EdgeCoil/wiegand-bridge/hardware/fab/render-bottom.png

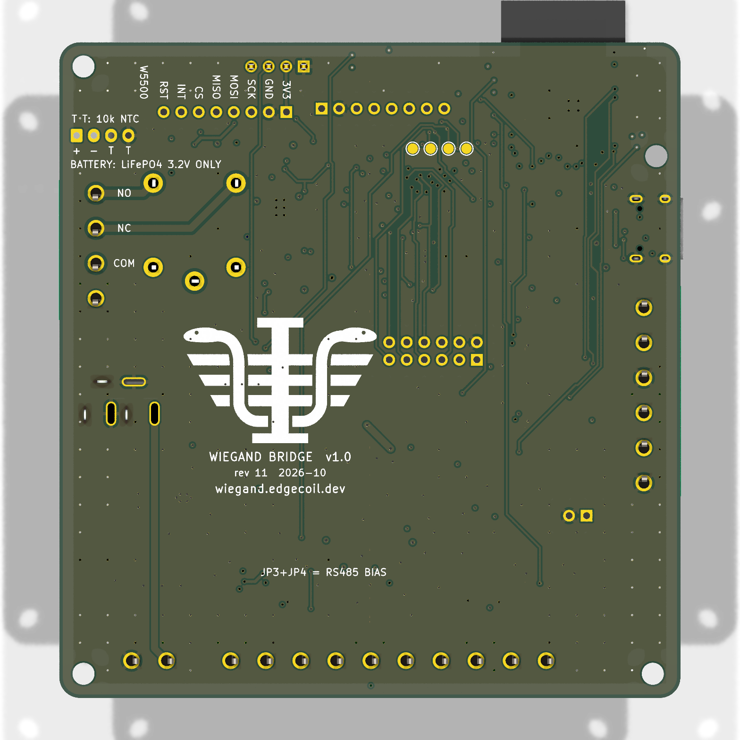
hardware/fab/render-bottom.png
