EdgeCoil/wiegand-bridge/hardware/fab/render-perspective.png

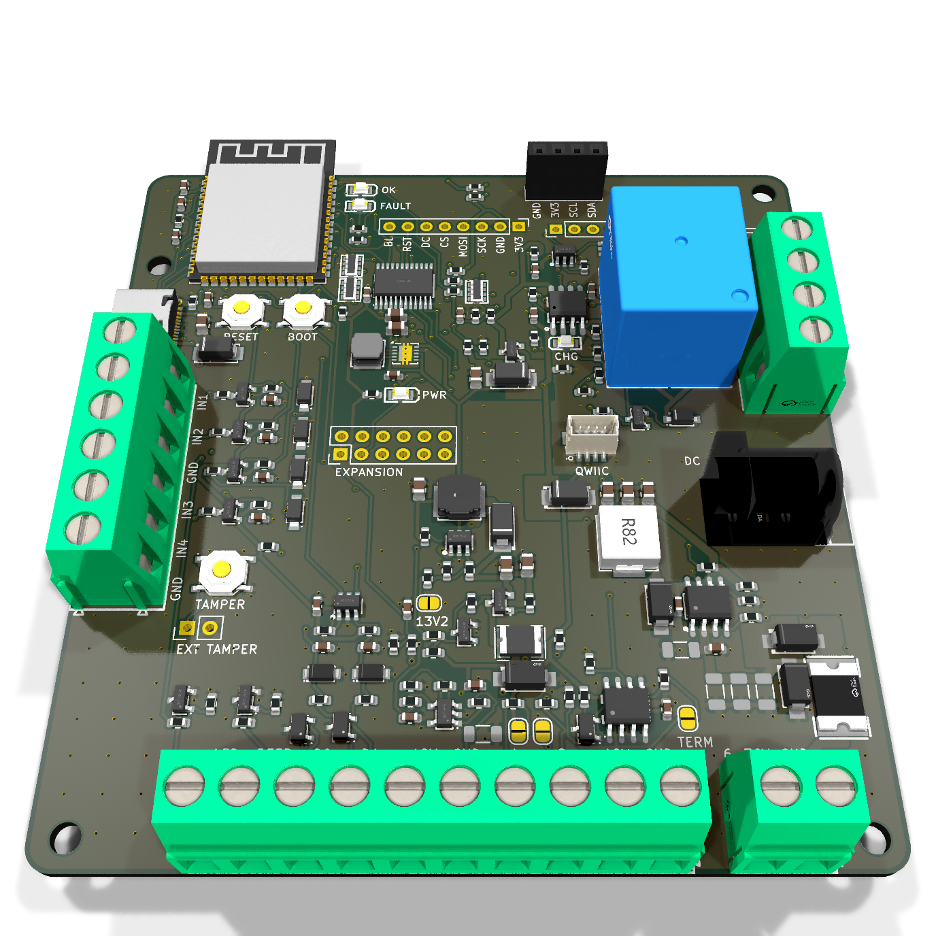
hardware/fab/render-perspective.png
