EdgeCoil/wiegand-bridge/hardware/lite/fab/render-bottom.png

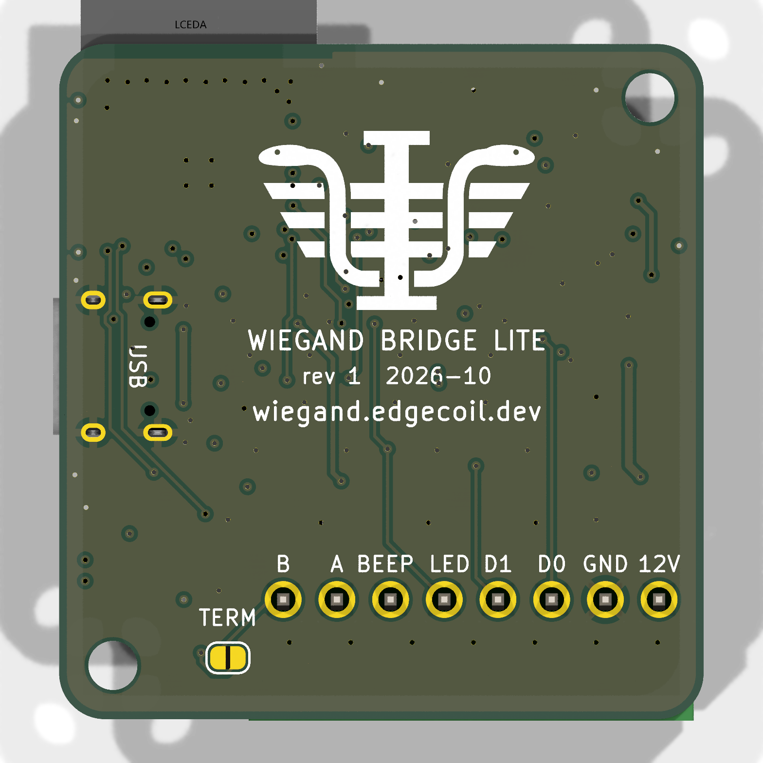
hardware/lite/fab/render-bottom.png
