EdgeCoil/wiegand-bridge/hardware/lite/fab/render-top.png

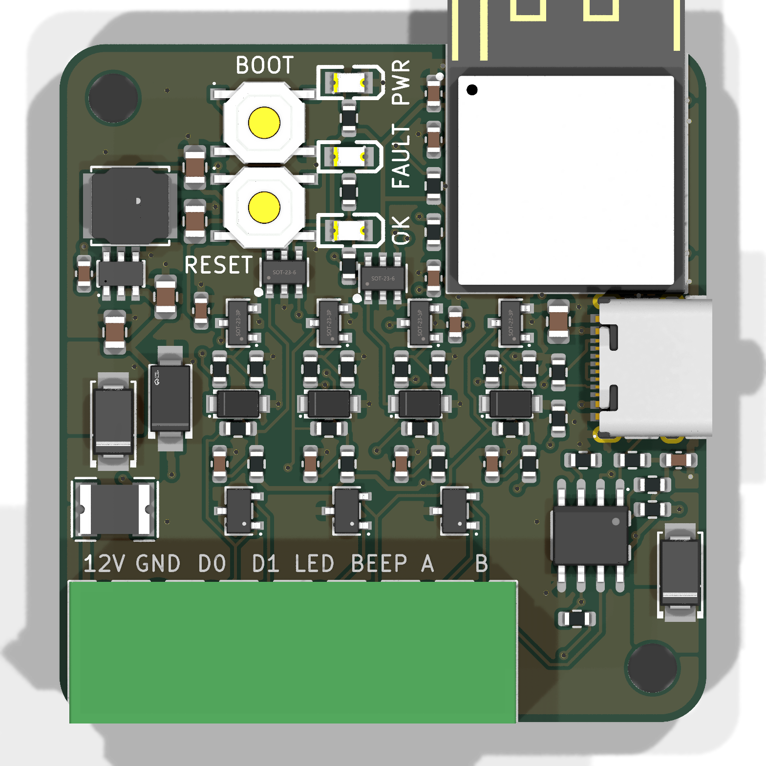
hardware/lite/fab/render-top.png
