EdgeCoil/wiegand-bridge/hardware/fab/wiegand-bridge-bom.csv

Comment | Designator | Footprint | LCSC Part #
22u | C11 | C_0603_1608Metric | C59461
1u | C13 | C_0603_1608Metric | C15849
100p | C14,C15 | C_0603_1608Metric | C14858
10n | C27,C28,C29,C30 | C_0603_1608Metric | C57112
10u | C2,C31,C32,C33 | C_1206_3216Metric | C13585
100n | C3,C12,C16,C22,C23,C24,C34,C36,C37,C38,C39,C40 | C_0603_1608Metric | C14663
22u | C4,C5,C7,C9,C10,C17,C18,C19,C35 | C_0805_2012Metric | C45783
10u | C6 | C_0805_2012Metric | C15850
10u | C8,C20,C21 | C_0603_1608Metric | C19702
SS56 | D1,D13 | SMA_L4.3-W2.6-LS5.0-RD | C18199169
1N4148W | D14 | SOD-123F_L2.7-W1.6-LS3.8-RD | C81598
SM712 | D15,D16,D19 | SOT-23-3_L3.0-W1.7-P0.95-LS2.9-BR | C32677
SMF36CA | D17,D18,D21,D22 | SOD-123FL_L2.7-W1.8-LS3.8-BI | C19077521
SMAJ36CA | D2 | SMA_L4.3-W2.6-LS5.0-RD | C19077551
SMAJ15A | D20 | SMA_L4.3-W2.6-LS5.0-RD | C19077535
SS34 | D3,D4,D10,D11 | SMA_L4.3-W2.6-LS5.2-RD | C8678
MMSZ5231B | D5,D6 | SOD-123_L2.8-W1.6-LS3.7-RD | C19077422
green | D7,D23 | LED0805-R-RD | C2297
red | D8,D12 | LED0805-RD | C84256
0.5A | F1 | F1812 | C516067
2A 60V | F2 | F2920 | C49326266
USB-C | J1 | USB-C-SMD_TYPE-C-16PIN-2MD-073 | C2765186
KF128-5.08-2P screw terminal | J2,J3,J9,J10,J11,J12,J13,J20,J21 | CONN-TH_P5.08_KF128-5.08-2P | C474952
LiFePO4 + NTC | J4 | JST_XH_B4B-XH-A_1x04_P2.50mm_Vertical | C144395
OLED SOCKET | J5 | HDR-TH_4P-P2.54-V-F | C2718488
15uH | L1 | IND-SMD_L7.0-W6.6_FXL0630 | C177243
2.2uH | L2 | IND-SMD_L4.0-W4.0 | C279948
4.7uH | L3 | IND-SMD_L5.0-W5.0 | C305174
2N7002 | Q1,Q2,Q4,Q7,Q8,Q9,Q10 | SOT-23-3_L2.9-W1.3-P1.90-LS2.4-BR | C8545
AO3401A | Q5,Q11 | SOT-23_L2.9-W1.3-P1.90-LS2.4-BR | C15127
AO3400A | Q12 | SOT-23-3_L2.9-W1.3-P1.90-LS2.4-BR | C20917
FS8205A | Q6 | SOT-23-6_L2.9-W1.6-P0.95-LS2.8-BR | C2830320
5.1k | R1,R2,R77 | R_0603_1608Metric | C23186
10k | R4,R5,R11,R12,R15,R18,R20,R35,R44,R45,R46,R47,R50,R60,R65,R74,R75,R76 | R_0603_1608Metric | C25804
15k | R16,R32 | R_0603_1608Metric | C22809
200k | R19,R30,R80 | R_0603_1608Metric | C25811
1k | R3,R8,R9,R10,R24,R26,R40,R41,R42,R43,R63,R70,R71,R81 | R_0603_1608Metric | C21190
4.7k | R36,R37 | R_0603_1608Metric | C23162
39k | R55 | R_0603_1608Metric | C23153
47k | R56 | R_0603_1608Metric | C25819
8.2k | R57 | R_0603_1608Metric | C25981
100k | R13,R14,R21,R27,R28,R29,R31,R51,R52,R58,R61,R62,R64,R79 | R_0603_1608Metric | C25803
0.2R | R59 | R_1206_3216Metric | C25335
100 | R6,R7,R17,R25 | R_0603_1608Metric | C22775
20k | R66,R67,R69 | R_0603_1608Metric | C4184
120 | R68 | R_0603_1608Metric | C22787
390 | R72,R73 | R_0603_1608Metric | C23151
68k | R78 | R_0603_1608Metric | C23231
4x10k | RN1,RN2,RN3 | RES-ARRAY-SMD_0603-8P-L3.2-W1.6-BL | C29718
10k NTC B3950 | RT1 | R_0603_1608Metric | C2892547
TS-1187A tact switch | SW1,SW2,SW3 | SW-SMD_4P-L5.1-W5.1-P3.70-LS6.5-TL_H1.5 | C318884
ESP32-S3-WROOM-1-N8R2 | U1 | WIRELM-SMD_ESP32-S3-WROOM-1 | C2913204
LMV321 | U10 | SOT-23-5_L3.0-W1.7-P0.95-LS2.8-BR | C7972
LMR16020 | U2 | SOIC-8_L4.9-W3.9-P1.27-LS6.0-BL-EP | C190006
TPS63001 | U3 | Texas_DRC0010J | C28060
SN74LVC2G17 | U4 | SOT-23-6_L2.9-W1.6-P0.95-LS2.8-BL | C10429
CN3058E | U5 | SOIC-8_L4.9-W3.9-P1.27-LS6.0-BL-EP3.3 | C112011
MT3608 | U6 | SOT-23-6_L2.9-W1.6-P0.95-LS2.8-BL | C84817
DW01A | U7 | SOT-23-6_L2.9-W1.6-P0.95-LS2.8-BL | C351410
TCA9535 | U8 | TSSOP-24_L7.8-W4.4-P0.65-LS6.4-BL | C130204
SP3485 | U9 | SOIC-8_L5.0-W4.0-P1.27-LS6.0-BL | C8963
