EdgeCoil/wiegand-bridge/hardware/fab/wiegand-bridge-schematic.pdf

# Wiegand reader bridge — revision 11 schematic

Generated from netlist.py (netlistsvg). Supply nets are flags; nets shared between blocks are named ports. IC pins are shown as

1. Block 1: 6-36 V input 2. Block 2: buck to 5 V (LMR16020, 60 V; datasheet SNVSAH8A sec. 8.2) 3. Block 3: USB-C, +5V, VSYS 4. Block 4: 3.3 V buck-boost 5. Block 5: MCU 6. Block 6: Wiegand inputs 7. Block 7: LED and BEEP 8. Block 8: reader supply 9. Block 9: battery 10. Block 10: screens 11. Block 11: inputs 12. Block 12 (rev 10): I/O expander, TCA9535 at 0x20 13. Block 13 (rev 10): relay -- driver fitted, relay and terminals NOT fitted 14. Block 14 (rev 10): RS-485 / OSDP on UART0 15. Block 15 (rev 10): surge/ESD on every field wire (SM712: +12 / -7 V standoff) 16. Block 16 (rev 10): reader current sense 17. Block 17 (rev 10): W5500 module header and Qwiic, not fitted

+VIN_RAW

GND

J2 6-36V IN
1 2

GND

GND

+VIN_RAW

J14 DC IN
2

3

4

+VIN_RAW
+VIN_F

F2 2A 60V
1 2+VIN

+VIN_F

D1

+VIN
GND

D2

+VIN

GND

C31

10u

+VIN

GND

C32

10u

+VIN

GND

C33

10u

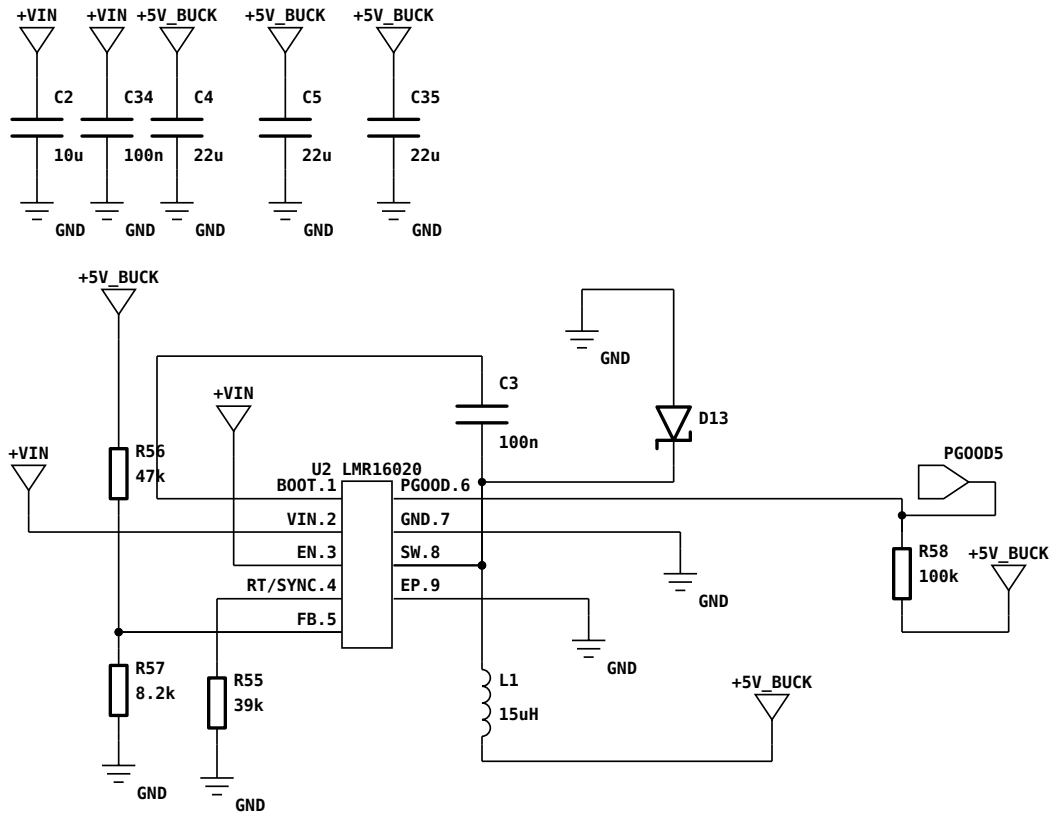
[picture p8: page 3]

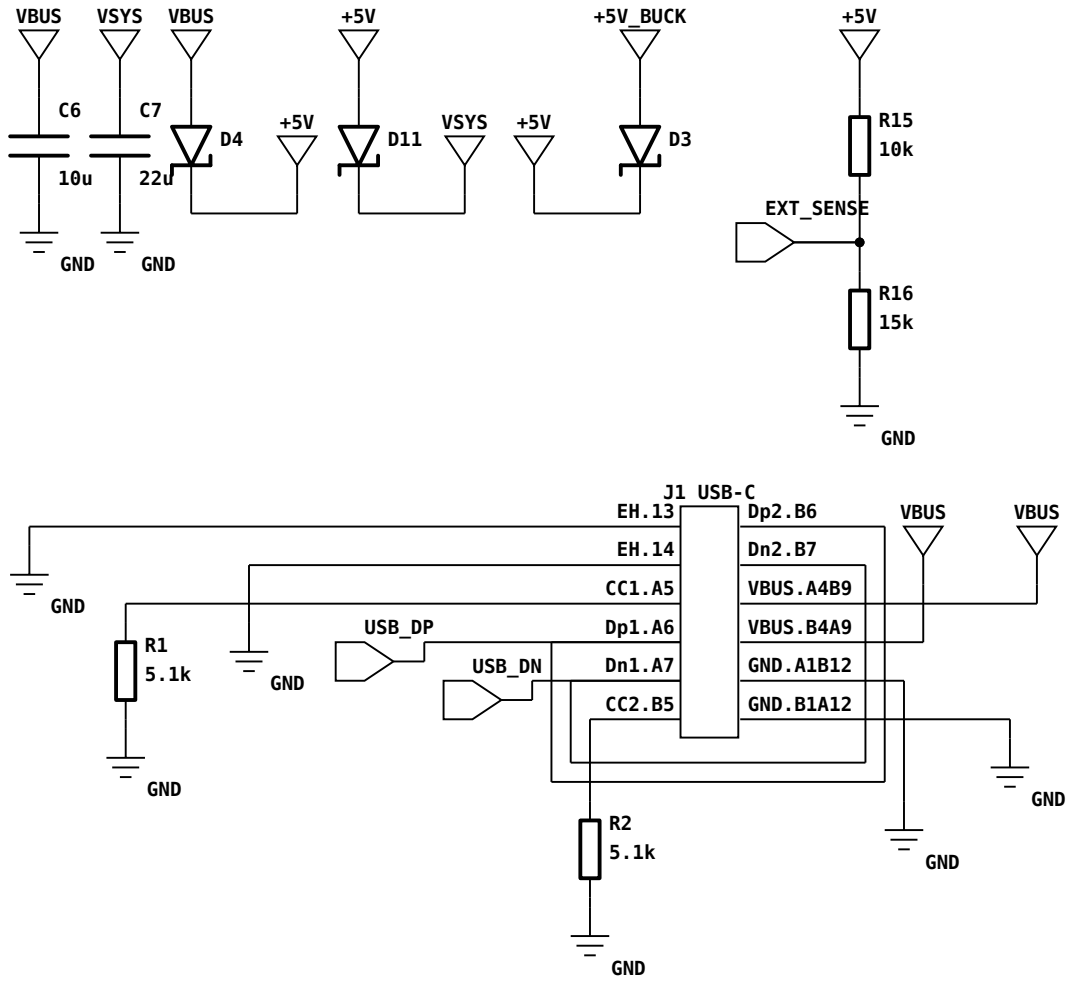
[picture p9: page 4]

VSYS

GND

C8

10u

+3V3

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
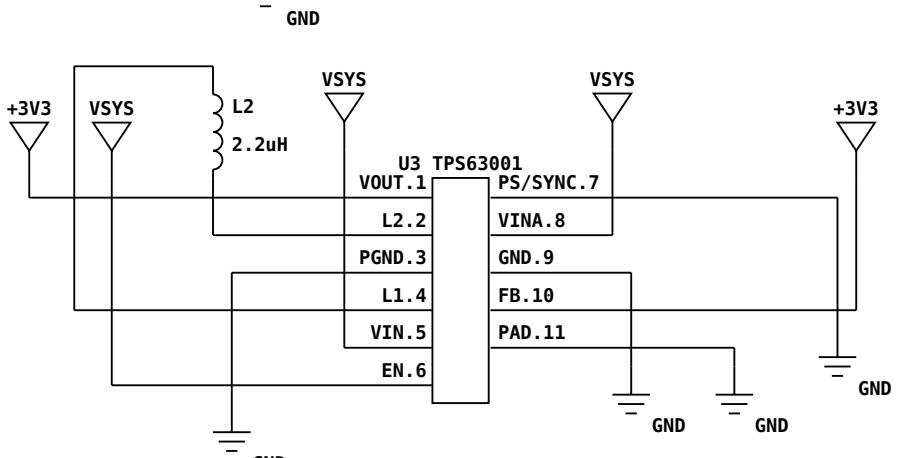
[picture p10: figure]
VSYS; GND; U3 TPS63001 VOUT.1; PGND.3; VIN.5; PS/SYNC.7; VINA.8; GND.9; PAD.11
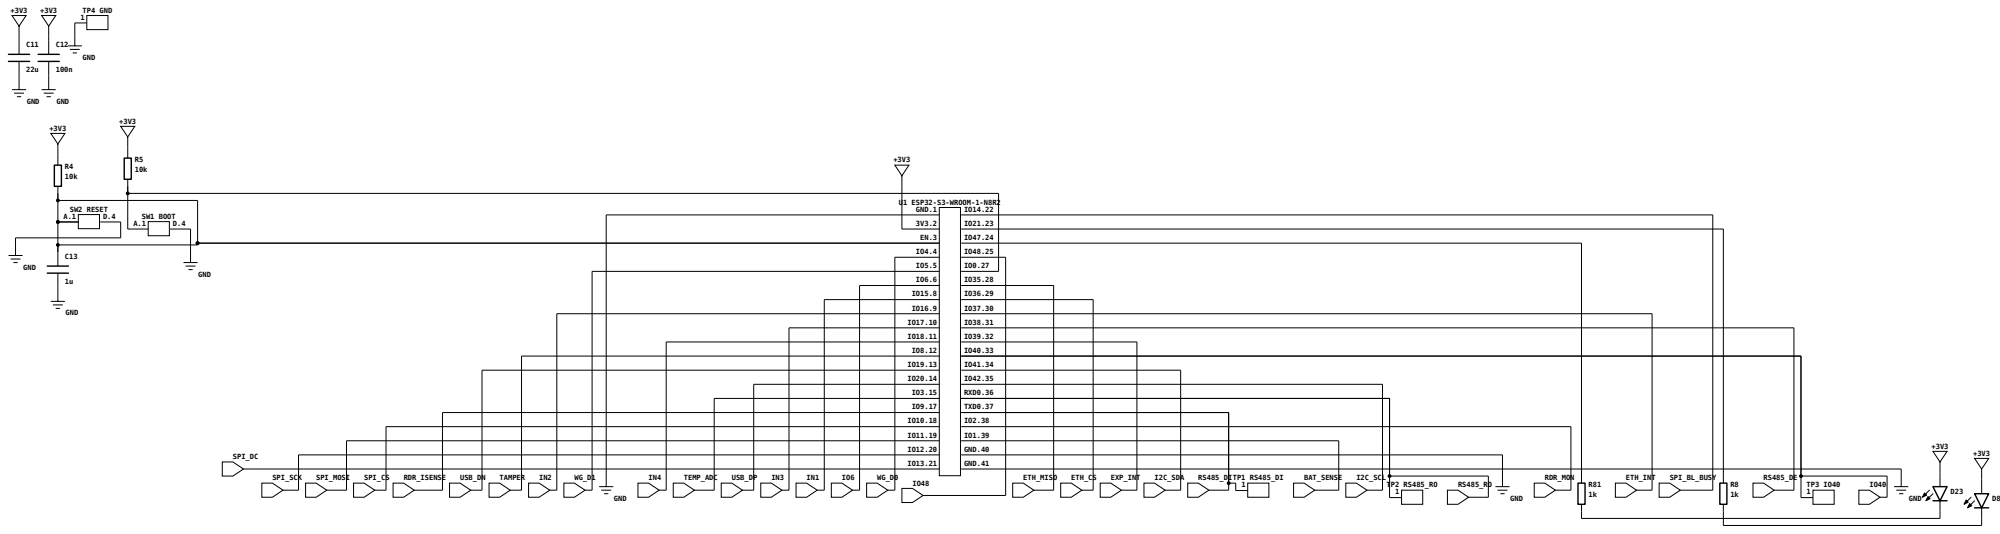
[picture p11: page 6]

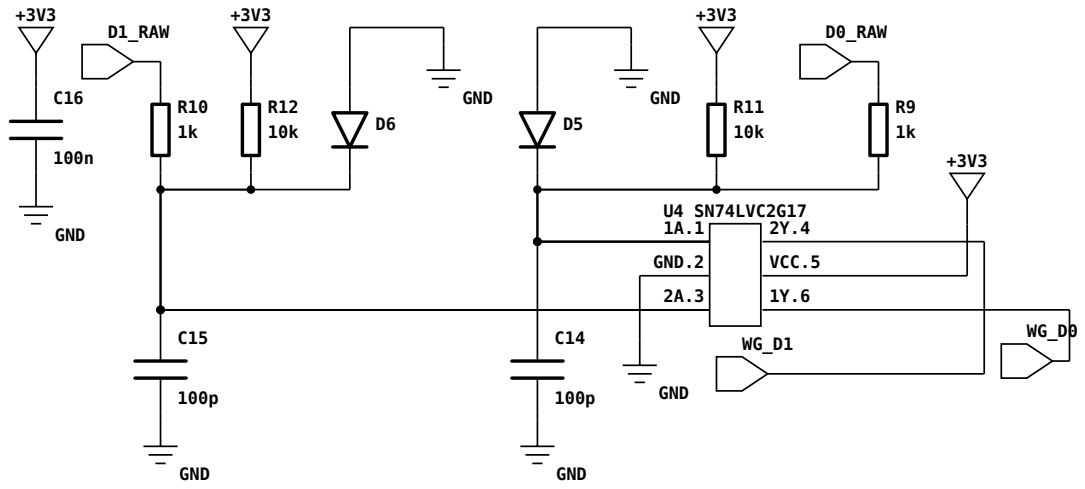
[picture p12: page 7]

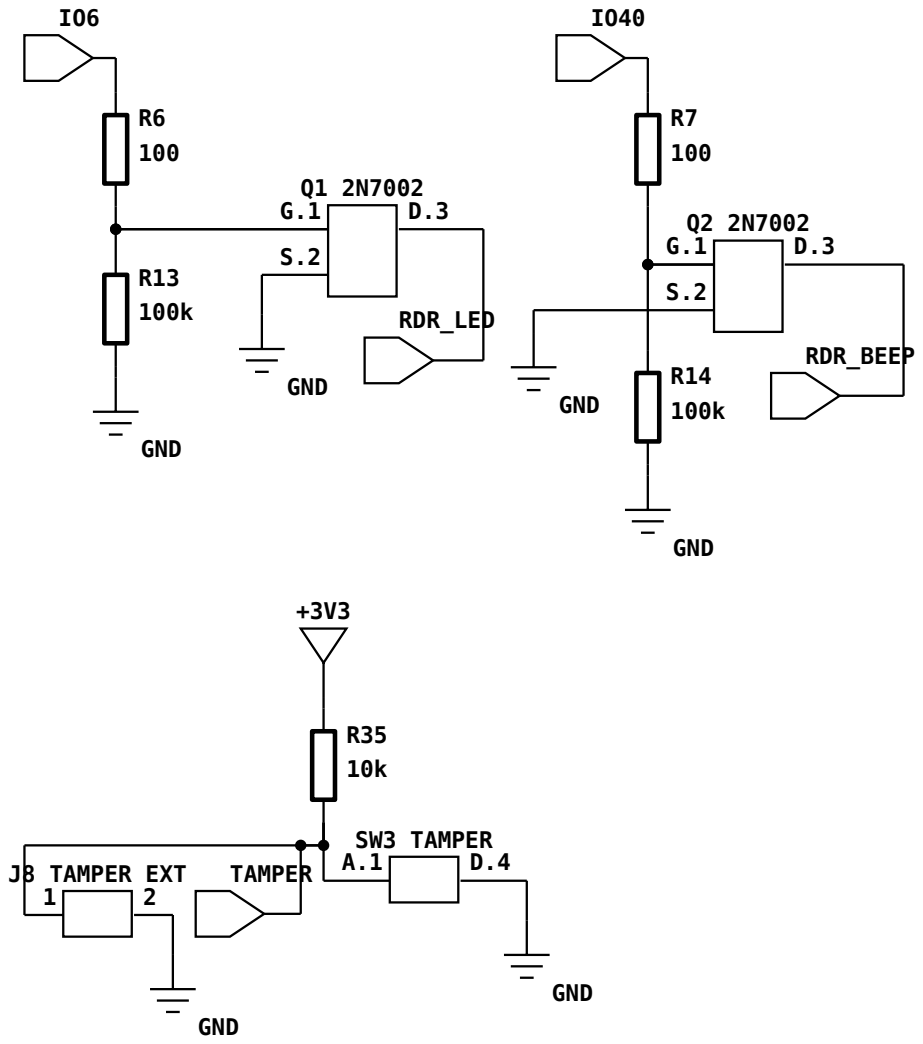
[picture p13: page 8]

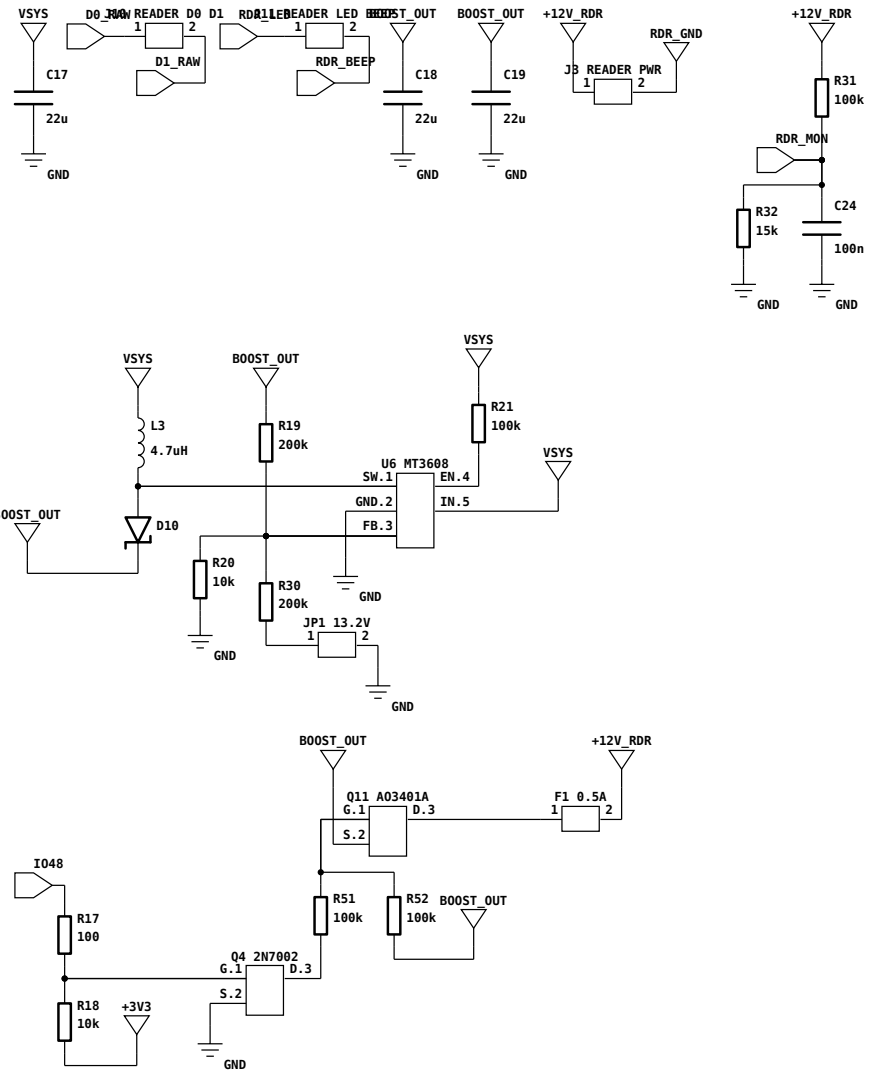
[picture p14: page 9]

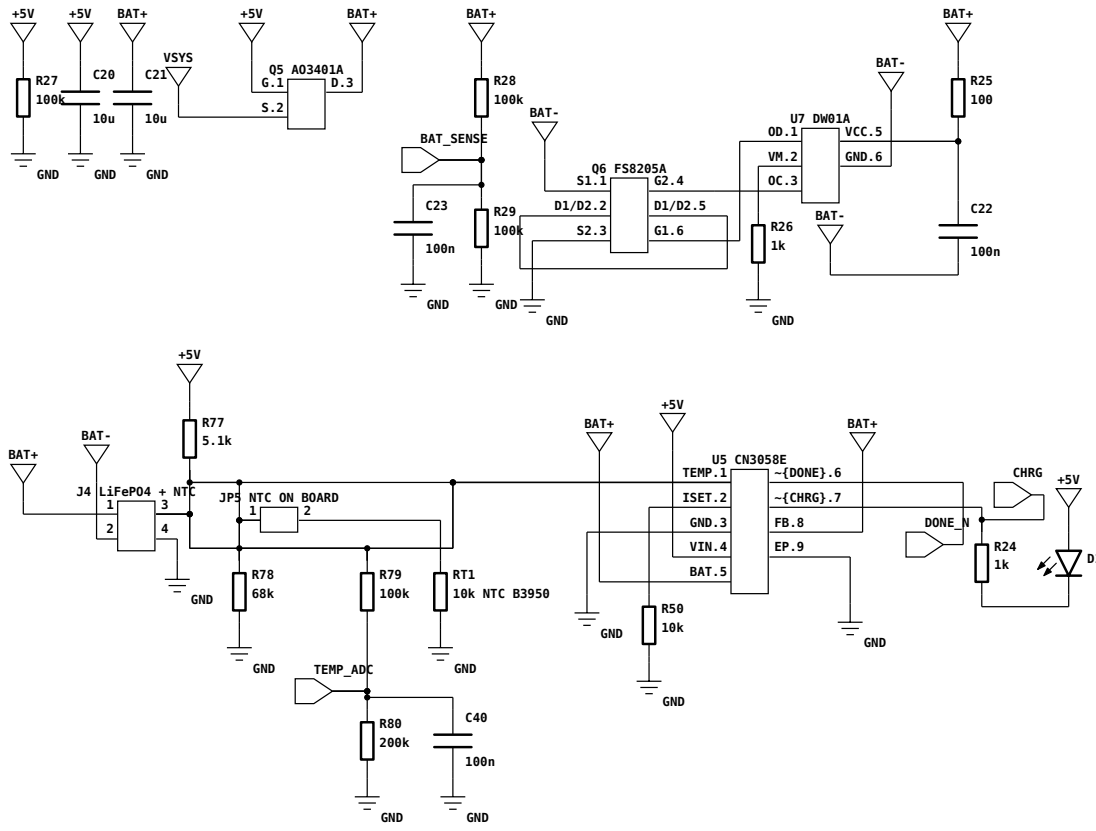
[picture p15: page 10]

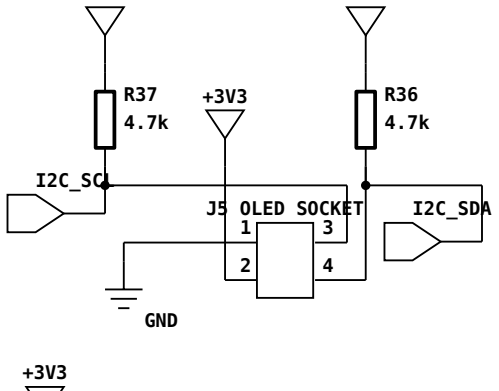
[picture p16: figure]
GND; J5 OLED SOCKET 1; I2C_SCL; I2C_SDA
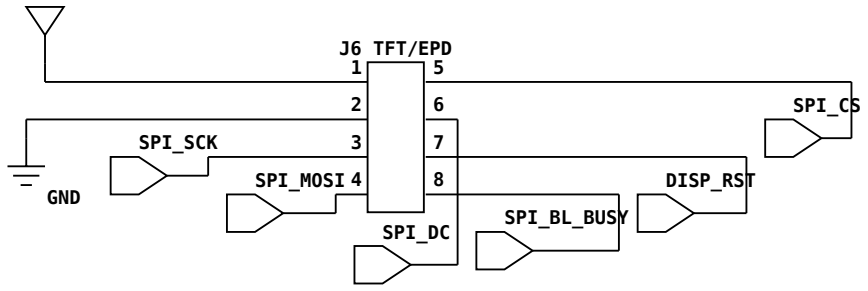
[picture p17: figure]
GND; J6 TFT/EPD 1; SPI_SCK; SPI_MOSI; SPI_CS; SPI_DC; DISP_RST; SPI_BL_BUSY
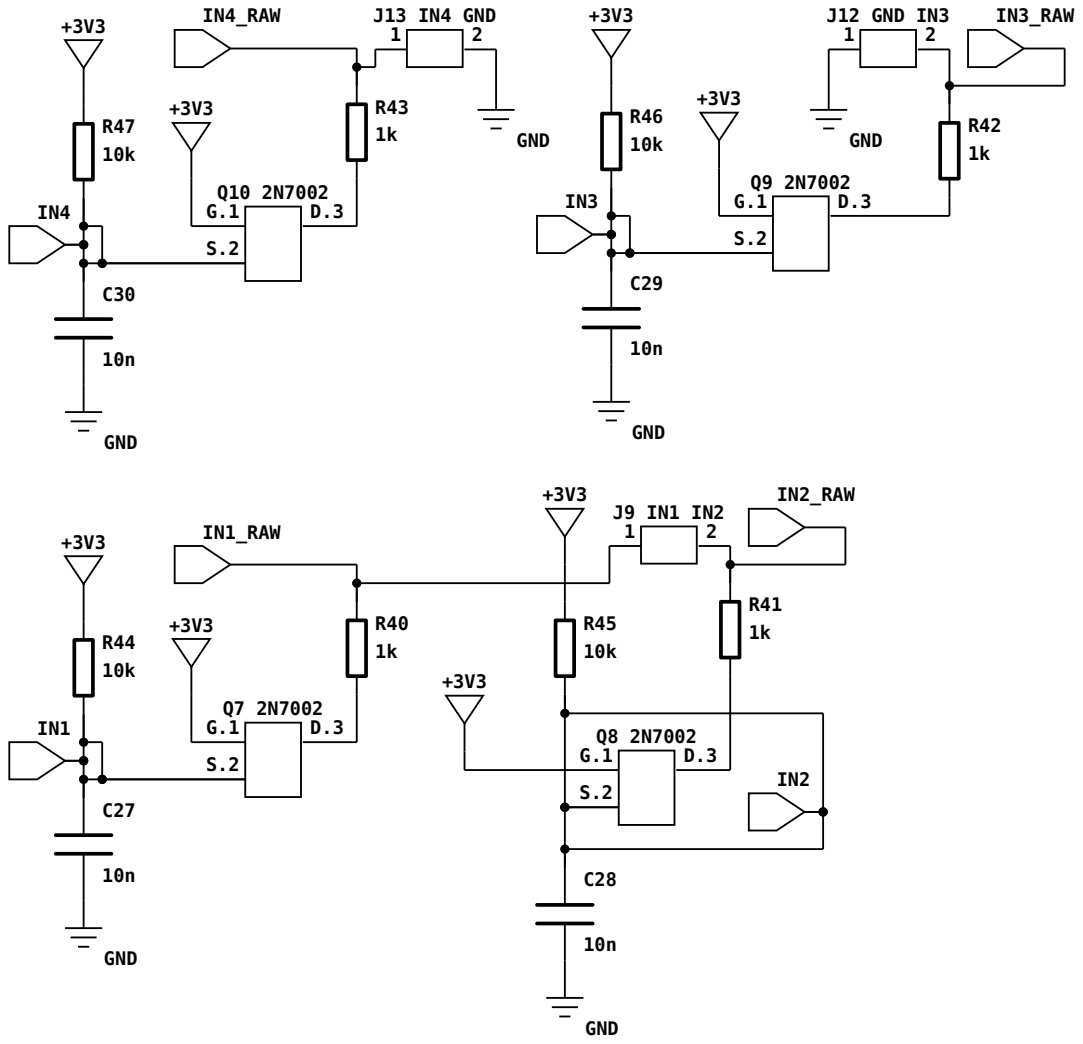
[picture p18: page 12]

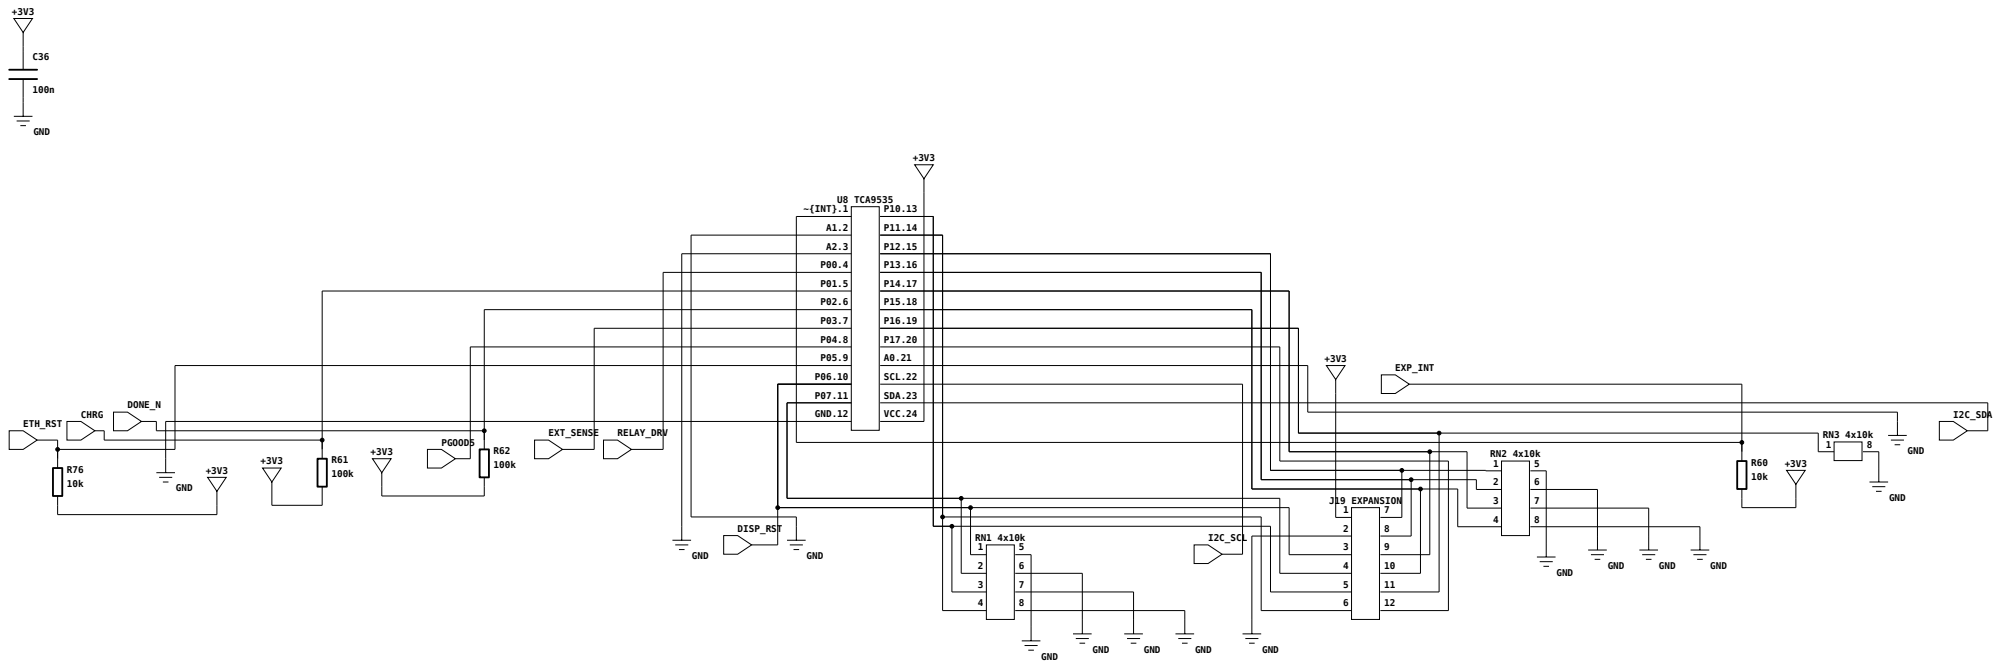
[picture p19: page 13]

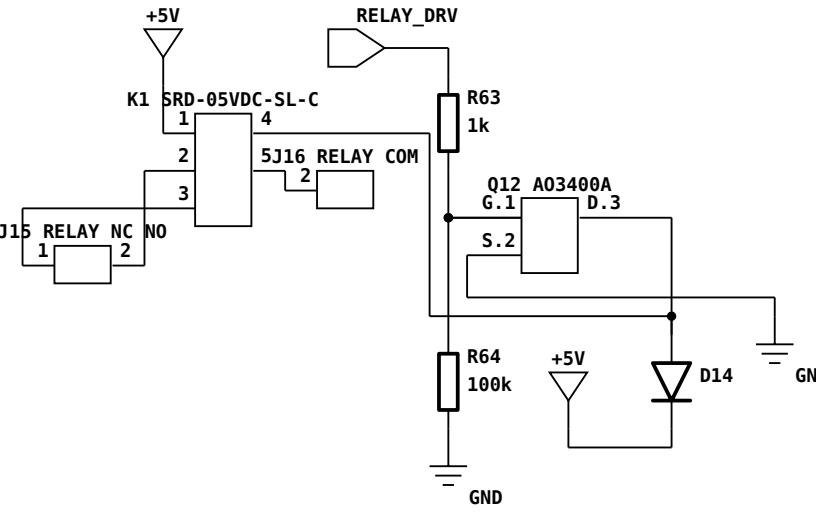
[picture p20: figure]
GND; SRD-05VDC-SL-C; J15 RELAY NC; J16 RELAY COM 2; RELAY_DRV
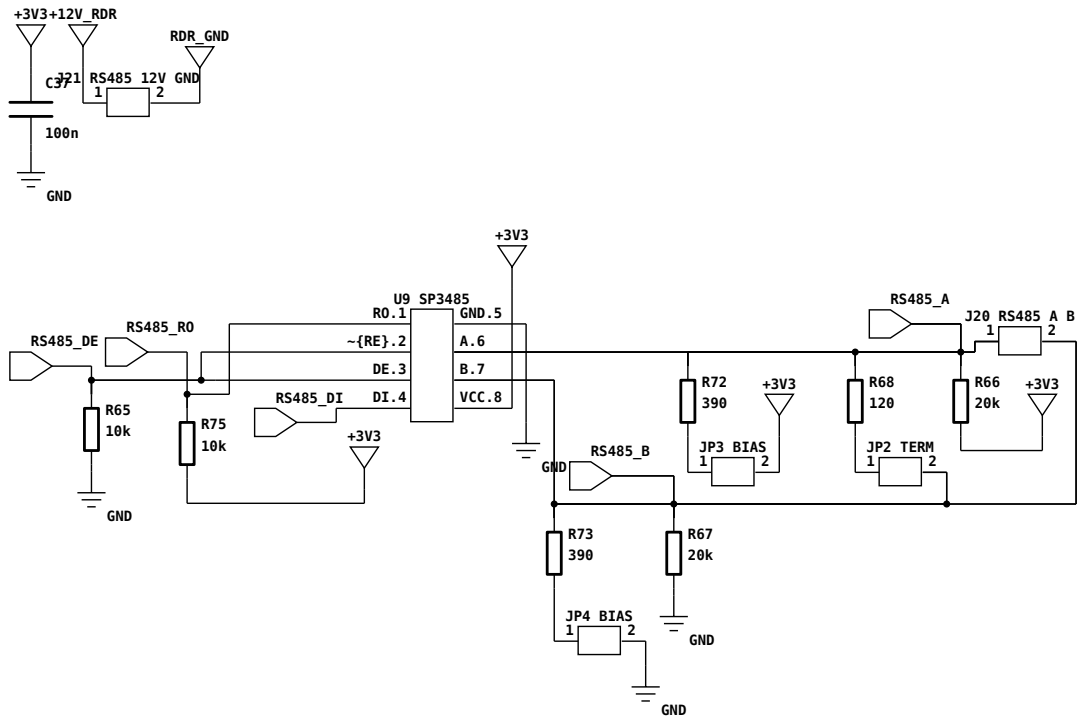
[picture p21: page 15]

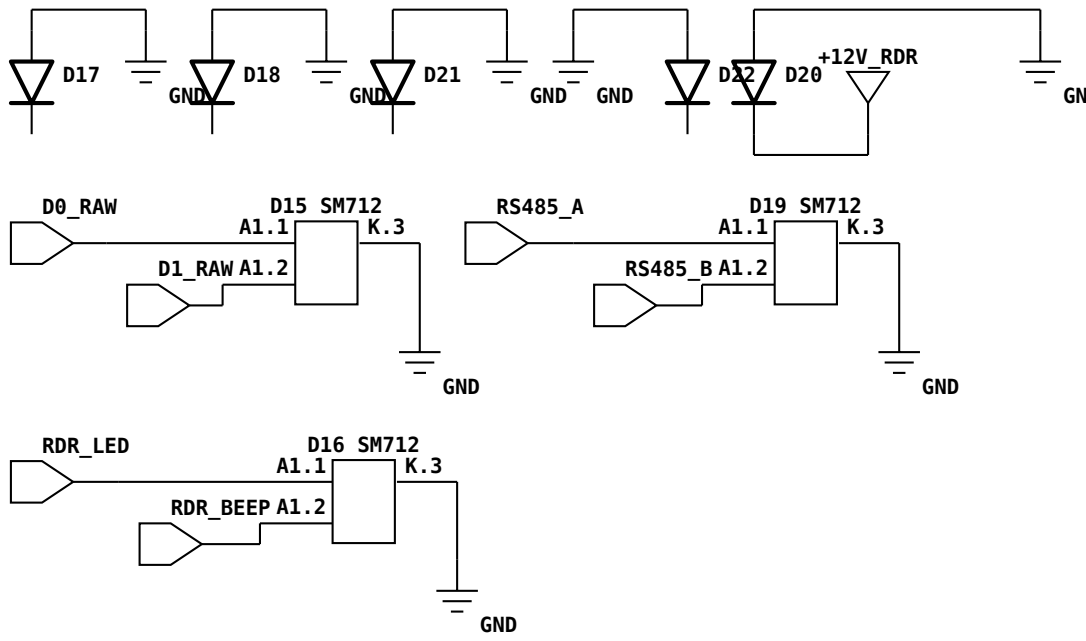
[picture p22: page 16]

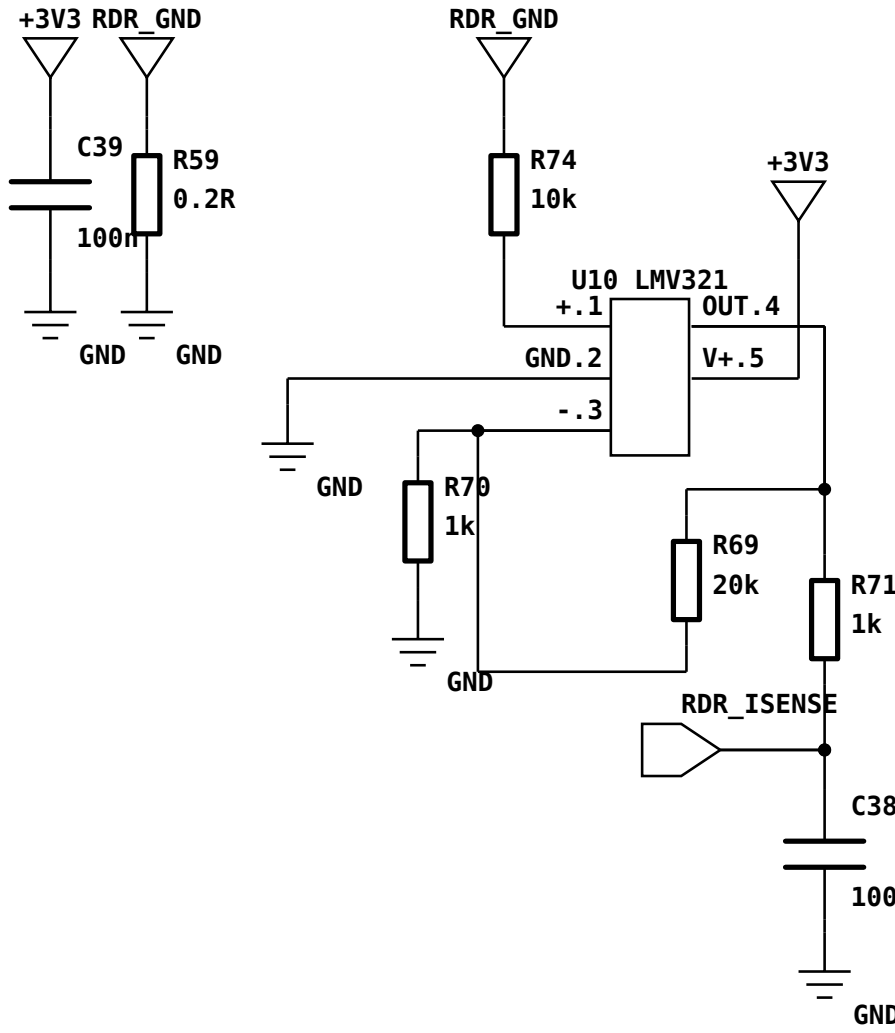
[picture p23: page 17]

J18 QWIIC
1

2

3

4
I2C_SDA

I2C_SCL

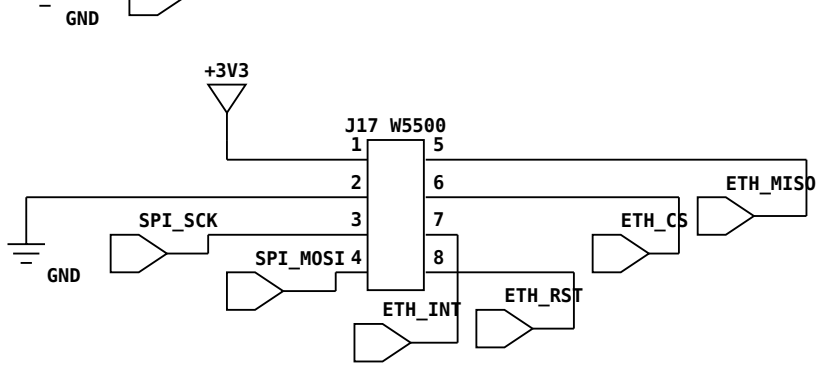
[picture p24: figure]
GND; SPI_SCK; SPI_MOSI; ETH_MISO; ETH_CS; ETH_INT; ETH_RST
