EdgeCoil/wiegand-bridge/hardware/lite/fab/wiegand-bridge-lite-1to1.pdf

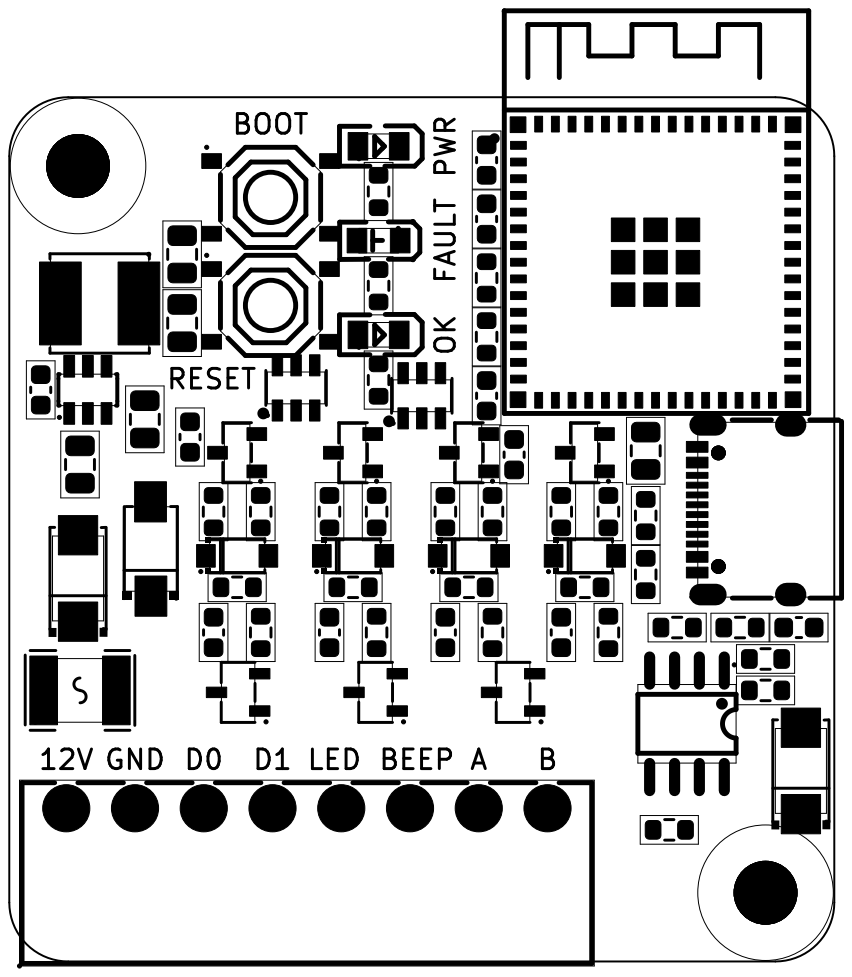
[picture p25: page 1]

Id: 1/1 Title: File: wiegand-bridge-lite.kicad_pcb Sheet:
