EdgeCoil/wiegand-bridge/hardware/lite/fab/wiegand-bridge-lite-schematic.pdf

# Wiegand bridge LITE — revision 1 schematic

Generated from netlist.py (netlistsvg). Supply nets are flags; nets shared between blocks are named ports. IC pins are shown as

1. Block 1: terminal block and 8-16 V input 2. Block 2: buck to 3.3 V (AP63203, datasheet figure 21) 3. Block 3: USB-C (programming, and bench power through D3) 4. Block 4: MCU, buttons, status LEDs 5. Block 5: reader lines D0, D1, LED, BEEP -- bidirectional cells 6. Block 6: RS-485 / OSDP on UART0 (rev 10 block 14, less the strong-bias jumpers) 7. Block 7: surge/ESD on every field wire (SM712: +12 / -7 V standoff)

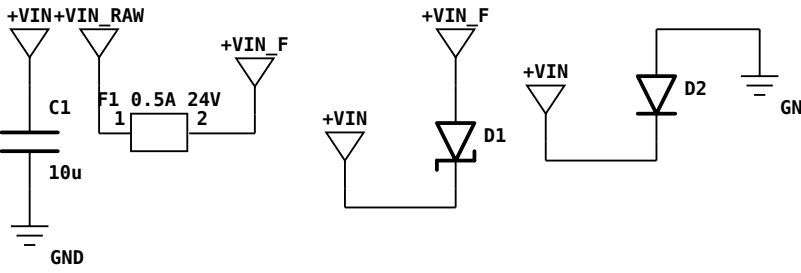
[picture p26: figure]
+VIN_RAW; +VIN_F; +VIN; GND
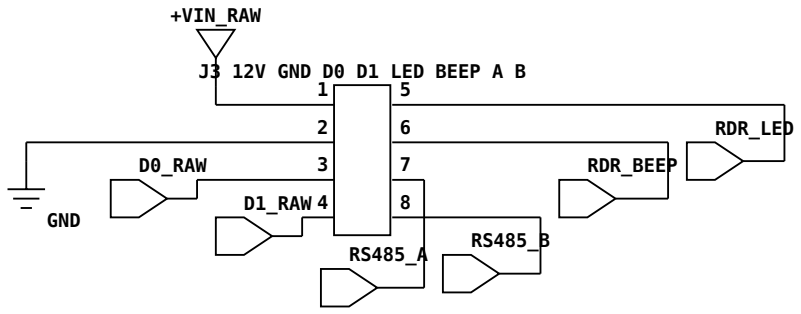
[picture p27: figure]
+VIN_RAW; GND; J3 12V GND D0 D1 LED BEEP A B 1; D0_RAW; D1_RAW; RDR_LED; RDR_BEEP
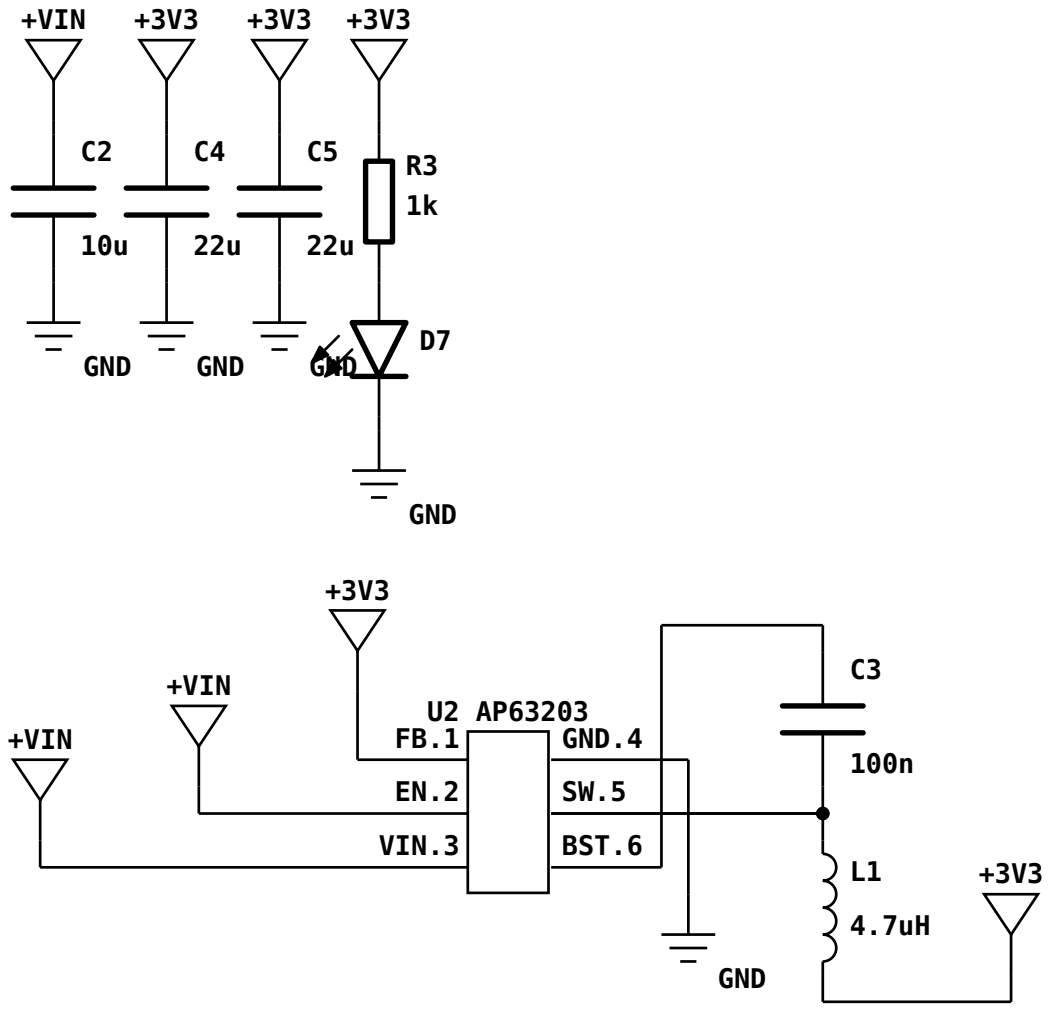
[picture p28: page 3]

J1 USB-C

VBUS

GND

C6

10u

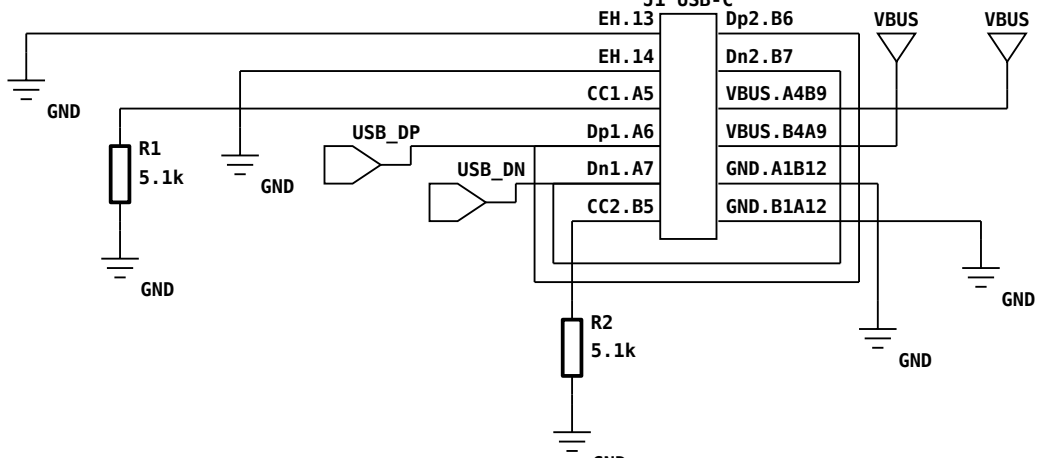
[picture p29: figure]
GND; VBUS; VBUS.A4B9; VBUS.B4A9; GND.A1B12; GND.B1A12; USB_DP; USB_DN

GND

+VIN

VBUS

D3

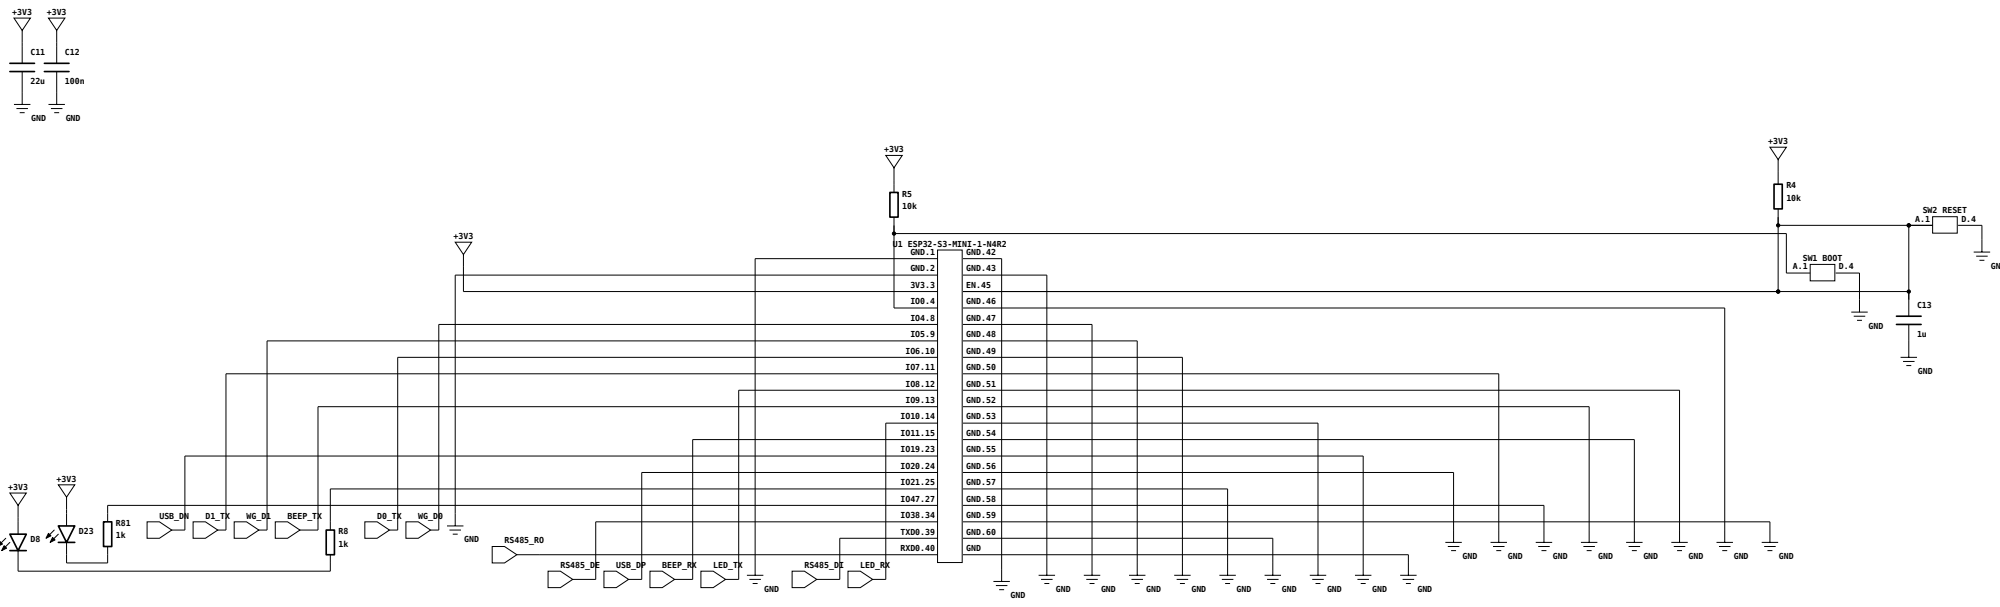
[picture p30: page 5]

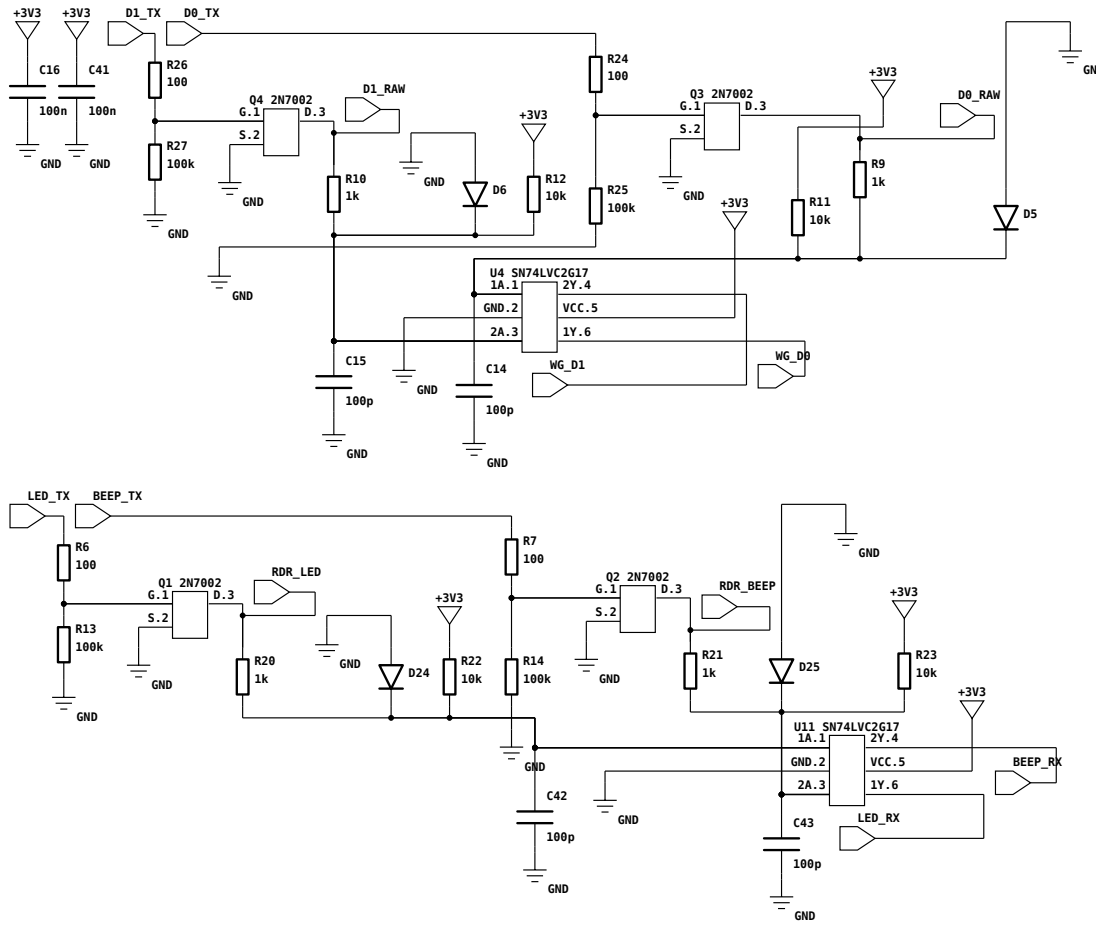
[picture p31: page 6]

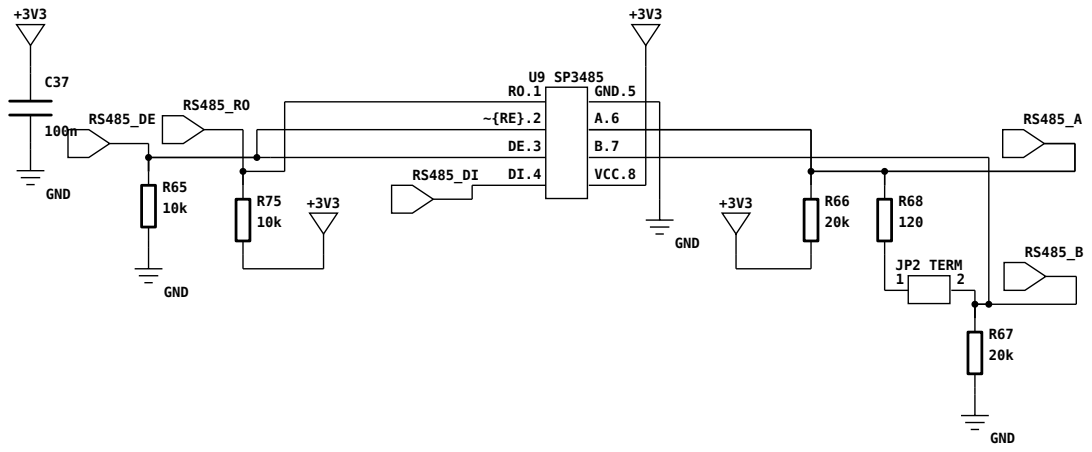
[picture p32: page 7]

GND

D15 SM712
A1.1

A1.2

K.3

D16 SM712
A1.1

A1.2

K.3

GND

D19 SM712
A1.1

A1.2

K.3

D0_RAW

D1_RAW

RDR_LED

RDR_BEEP

RS485_A

RS485_B
