EdgeCoil/wiegand-bridge/hardware/fab/wiegand-bridge-1to1.pdf

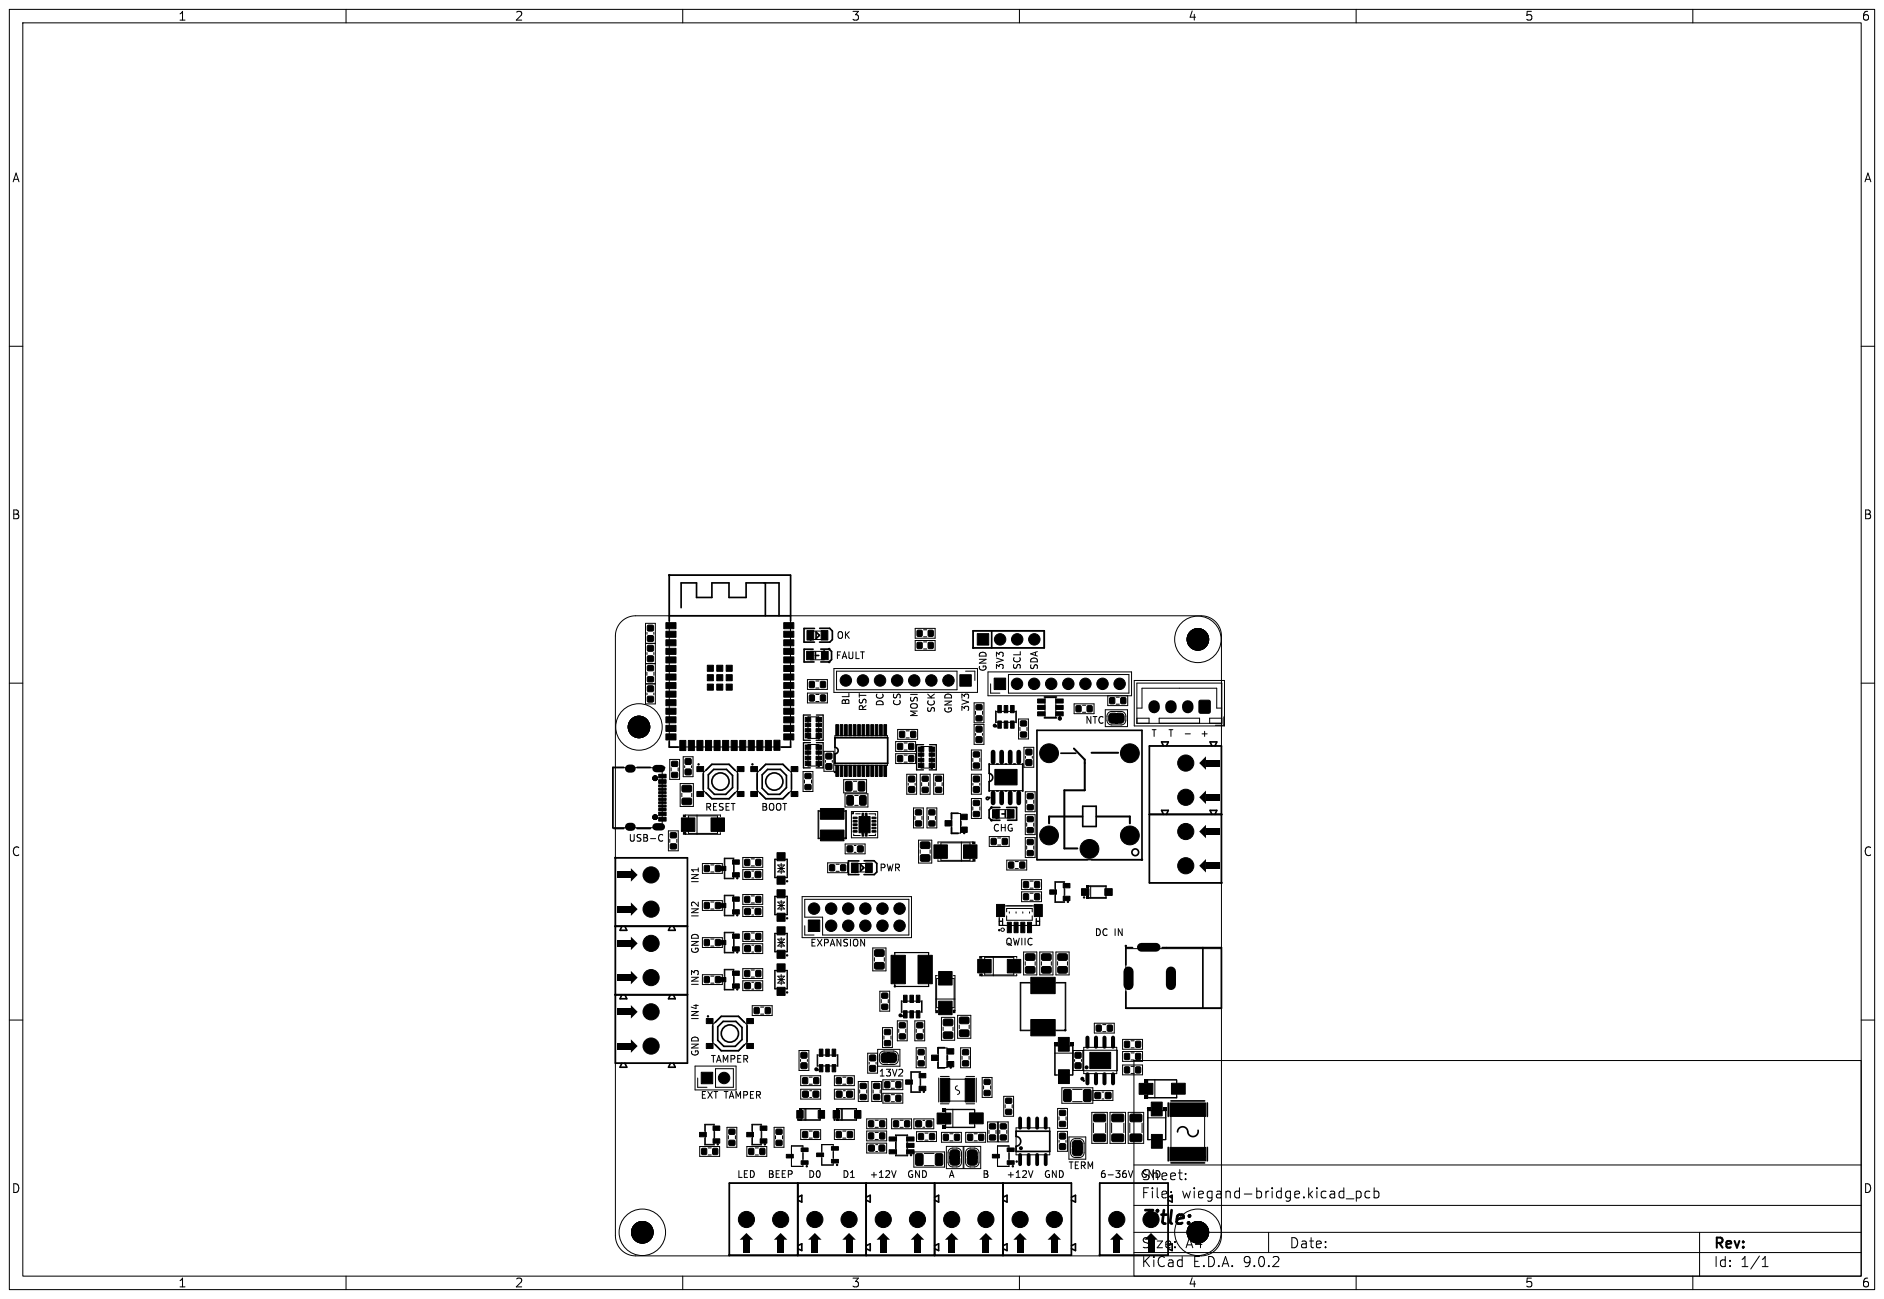
[picture p33: page 1]
