EdgeCoil/wiegand-bridge/hardware/fab/wiegand-bridge-assembly.pdf

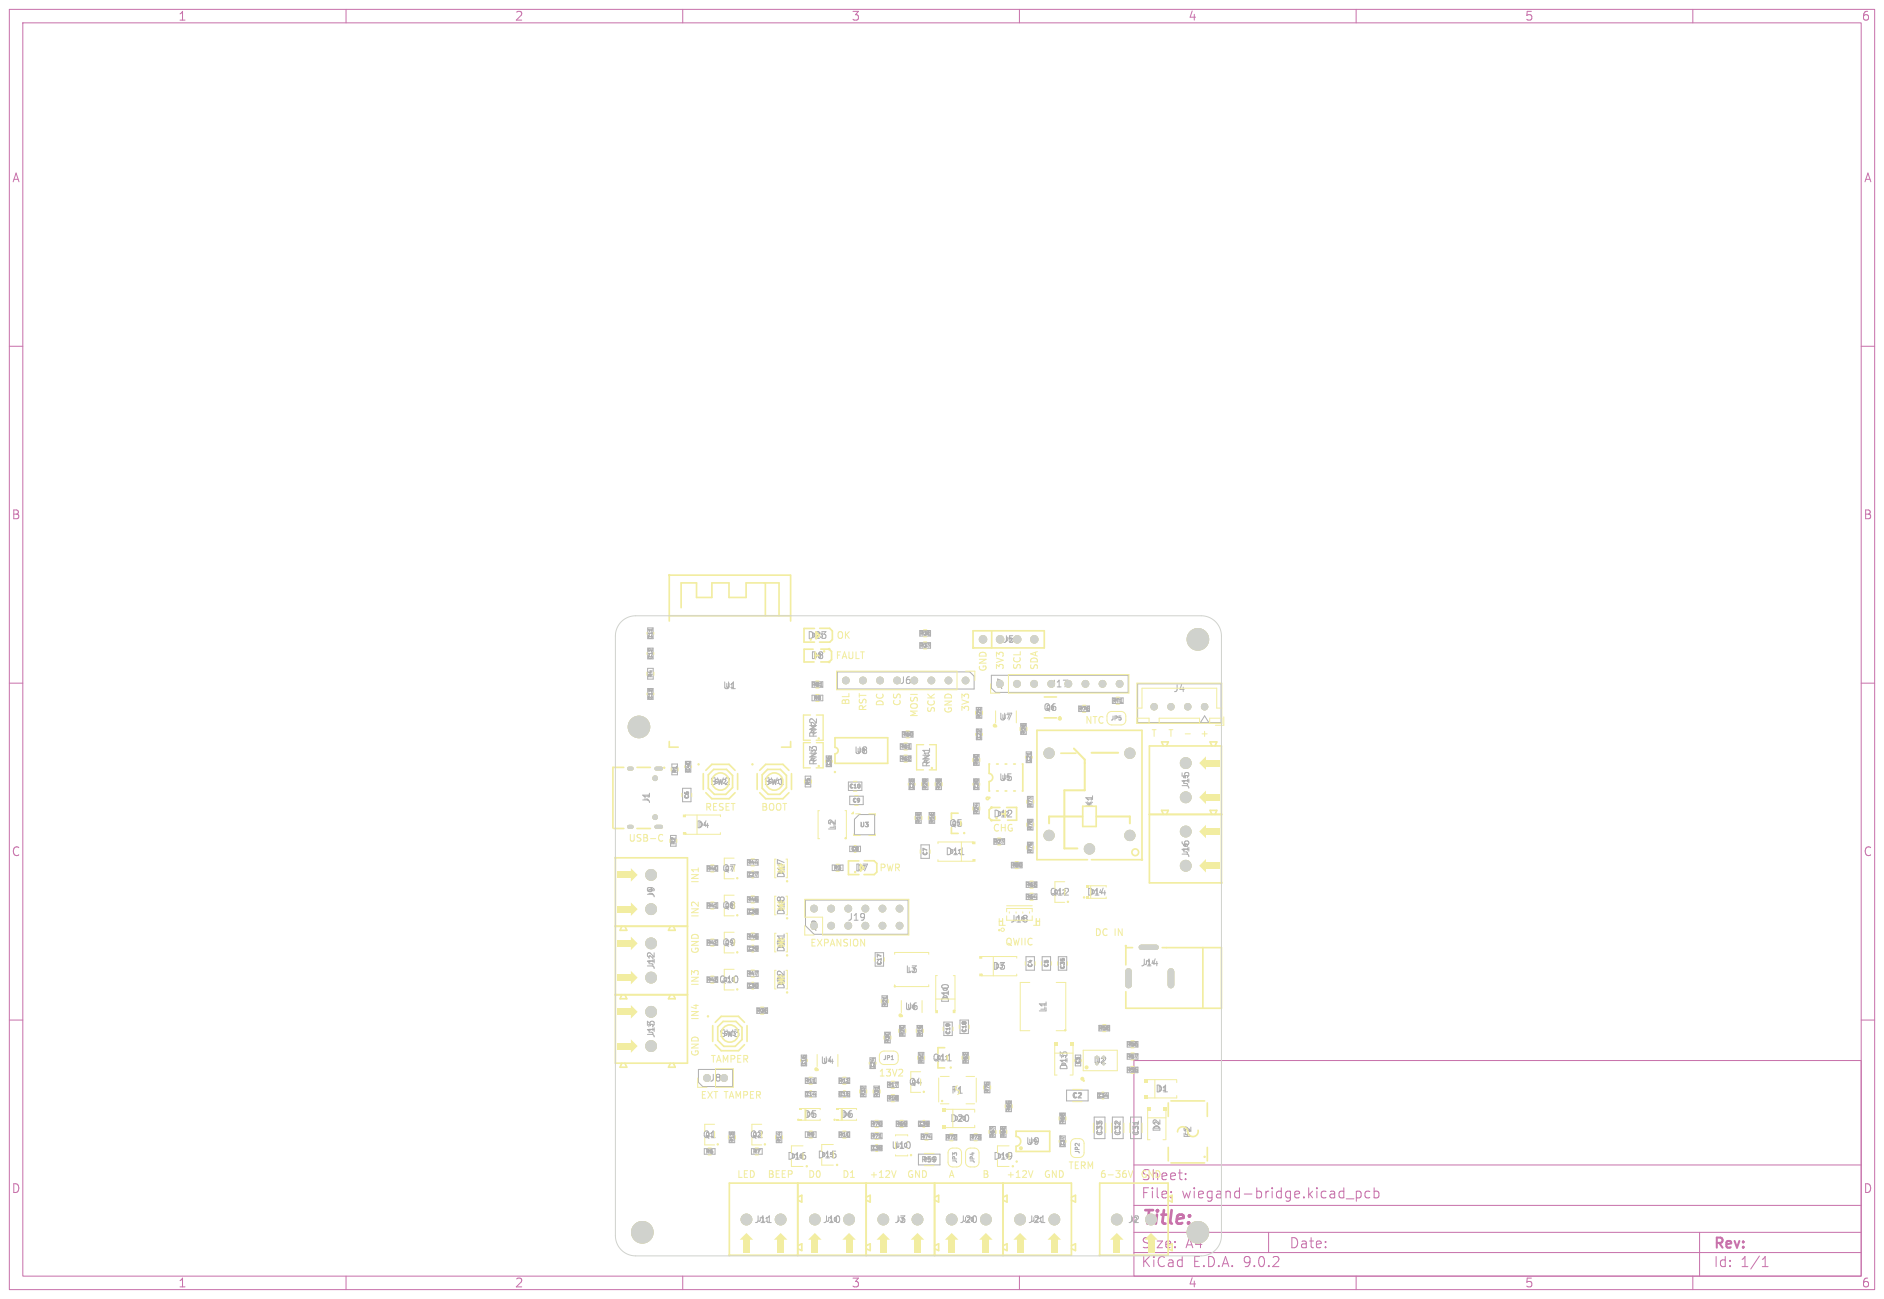
[picture p34: page 1]
