EdgeCoil/wiegand-bridge/hardware/lite/fab/wiegand-bridge-lite-assembly.pdf

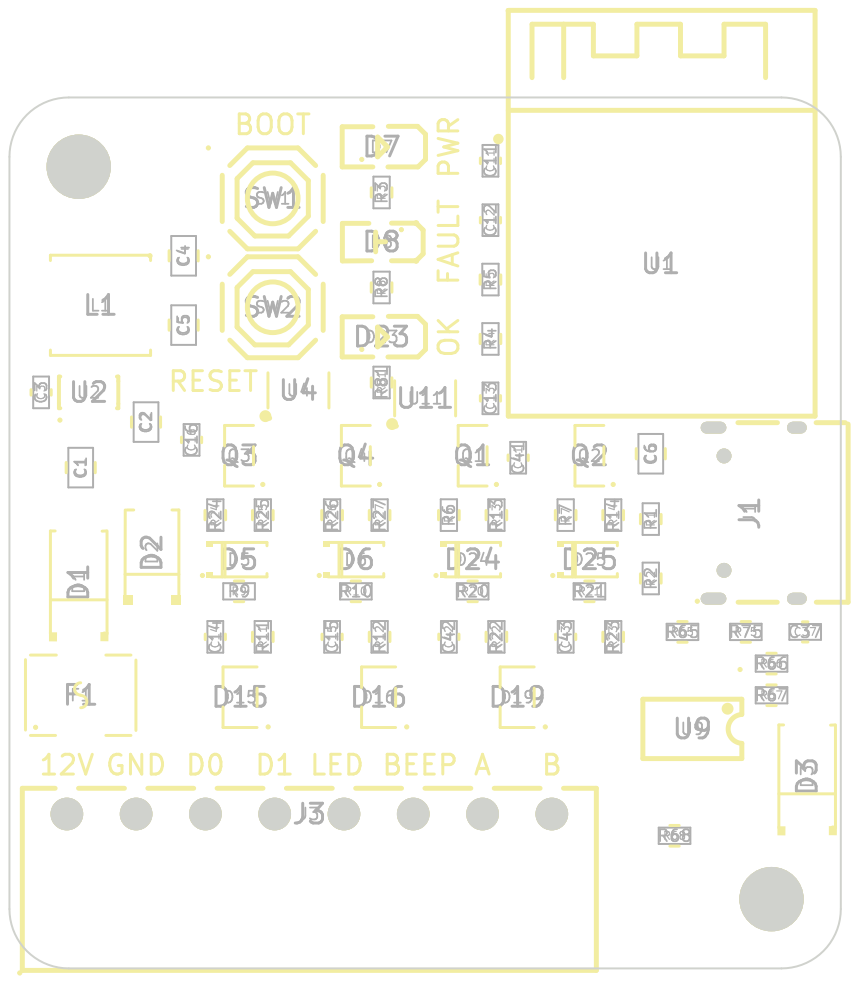
[picture p35: page 1]
