EdgeCoil/wiegand-bridge/hardware/wiegand-bridge.kicad_pcb

## KiCad design hardware/wiegand-bridge.kicad_pcb (2026-10-25)

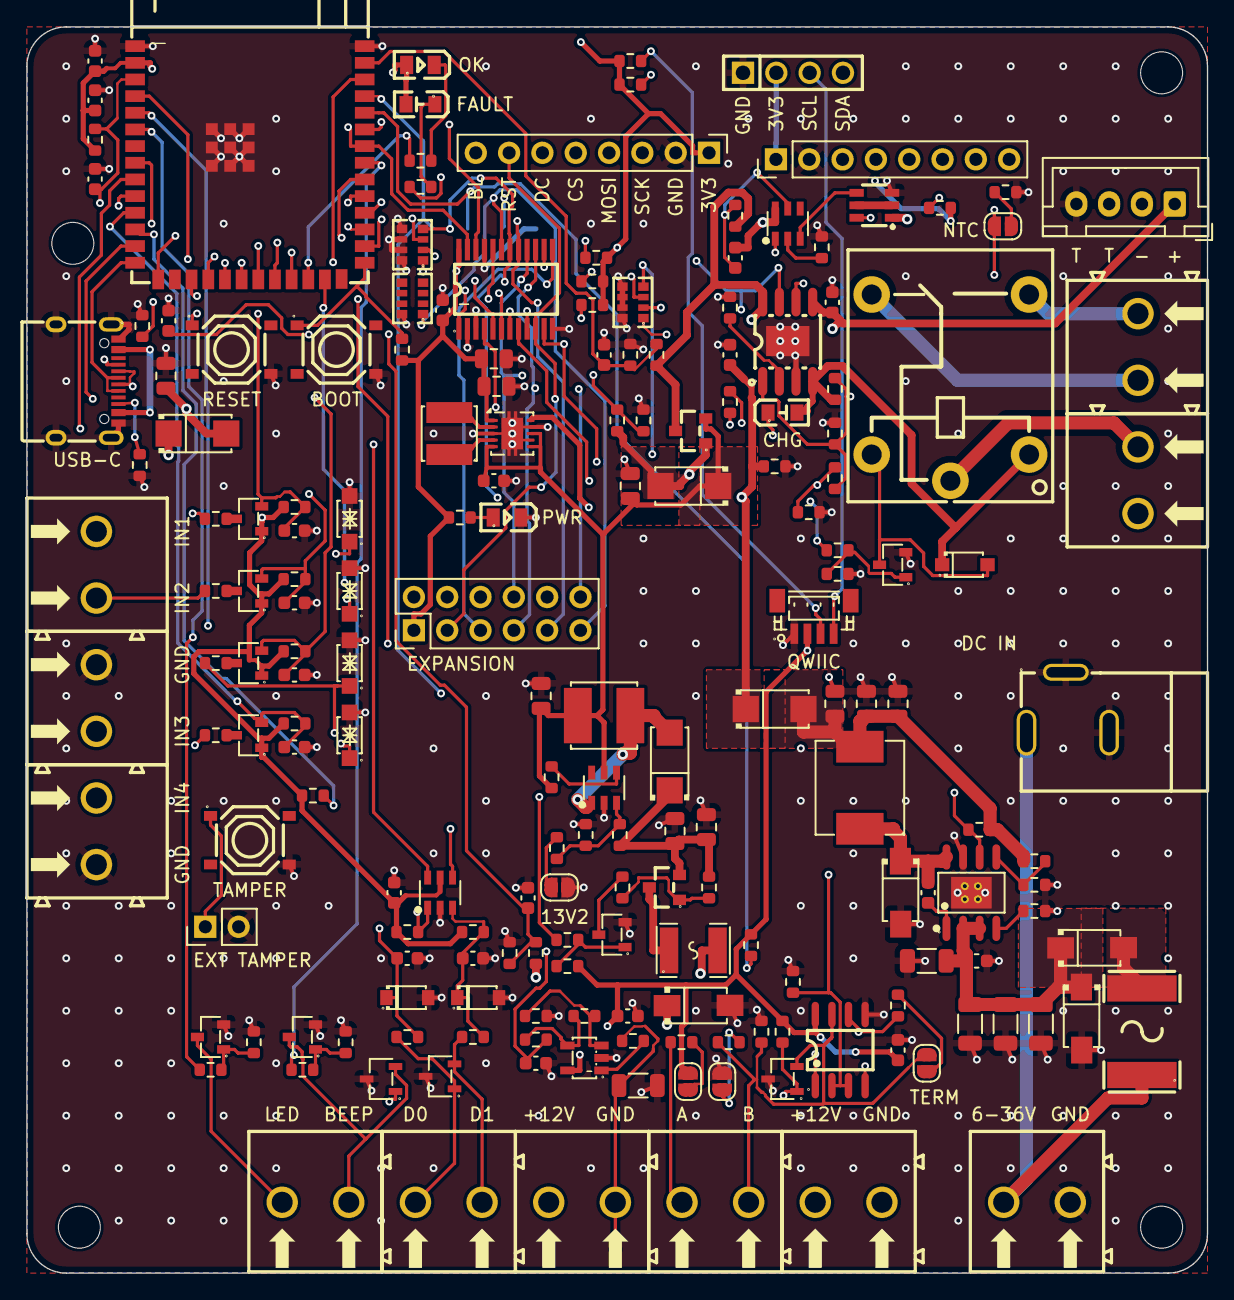
[picture p36: board wiegand-bridge.kicad_pcb from above]

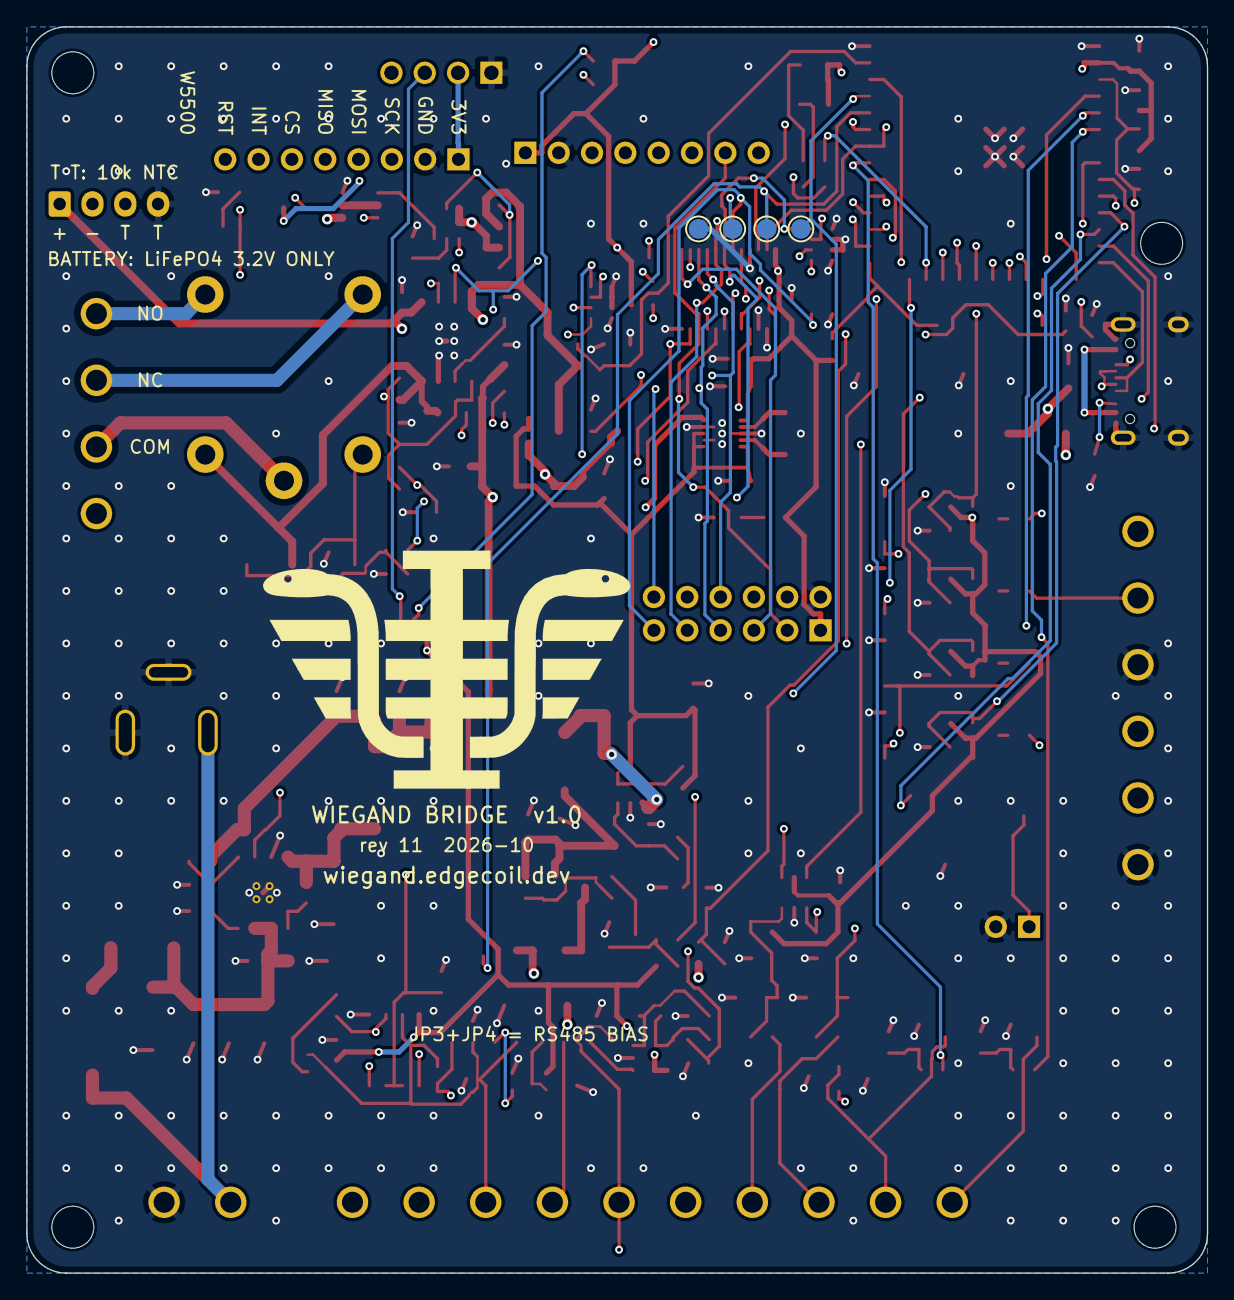
[picture p37: board wiegand-bridge.kicad_pcb from below]

Board: 4 copper layers, 90.0 x 95.0 mm, 197 parts (4 on the bottom side), 121 nets.

Parts:
C2, C31, C32, C33: 10u; C_1206_3216Metric
C3, C12, C16, C22, C23, C24, C34, C36, C37, C38, C39, C40: 100n; C_0603_1608Metric
C4, C5, C7, C9, C10, C17, C18, C19, C35: 22u; C_0805_2012Metric
C6: 10u; C_0805_2012Metric
C8, C20, C21: 10u; C_0603_1608Metric
C11: 22u; C_0603_1608Metric
C13: 1u; C_0603_1608Metric
C14, C15: 100p; C_0603_1608Metric
C27, C28, C29, C30: 10n; C_0603_1608Metric
D1, D13: SS56; SMA_L4.3-W2.6-LS5.0-RD
D2: SMAJ36CA; SMA_L4.3-W2.6-LS5.0-RD
D3, D4, D10, D11: SS34; SMA_L4.3-W2.6-LS5.2-RD
D5, D6: MMSZ5231B; SOD-123_L2.8-W1.6-LS3.7-RD
D7, D23: green; LED0805-R-RD
D8, D12: red; LED0805-RD
D14: 1N4148W; SOD-123F_L2.7-W1.6-LS3.8-RD
D15, D16, D19: SM712; SOT-23-3_L3.0-W1.7-P0.95-LS2.9-BR
D17, D18, D21, D22: SMF36CA; SOD-123FL_L2.7-W1.8-LS3.8-BI
D20: SMAJ15A; SMA_L4.3-W2.6-LS5.0-RD
F1: 0.5A; F1812
F2: 2A 60V; F2920
H1, H2, H3, H4: M3; MountingHole_3.2mm_M3
J1: USB-C; USB-C-SMD_TYPE-C-16PIN-2MD-073
J2: 6-36V IN; CONN-TH_P5.08_KF128-5.08-2P
J3: READER PWR; CONN-TH_P5.08_KF128-5.08-2P
J4: LiFePO4 + NTC; JST_XH_B4B-XH-A_1x04_P2.50mm_Vertical
J5: OLED SOCKET; HDR-TH_4P-P2.54-V-F
J6: TFT/EPD; PinHeader_1x08_P2.54mm_Vertical
J8: TAMPER EXT; PinHeader_1x02_P2.54mm_Vertical
J9: IN1 IN2; CONN-TH_P5.08_KF128-5.08-2P
J10: READER D0 D1; CONN-TH_P5.08_KF128-5.08-2P
J11: READER LED BEEP; CONN-TH_P5.08_KF128-5.08-2P
J12: GND IN3; CONN-TH_P5.08_KF128-5.08-2P
J13: IN4 GND; CONN-TH_P5.08_KF128-5.08-2P
J14: DC IN; DC-IN-TH_DC-005-5.5-2.0
J15: RELAY NC NO; CONN-TH_P5.08_KF128-5.08-2P
J16: RELAY COM; CONN-TH_P5.08_KF128-5.08-2P
J17: W5500; PinHeader_1x08_P2.54mm_Vertical
J18: QWIIC; CONN-SMD_BM04B-SRSS-TB
J19: EXPANSION; PinHeader_2x06_P2.54mm_Vertical
J20: RS485 A B; CONN-TH_P5.08_KF128-5.08-2P
J21: RS485 12V GND; CONN-TH_P5.08_KF128-5.08-2P
JP1: 13.2V; SolderJumper-2_P1.3mm_Open_RoundedPad1.0x1.5mm
JP2: TERM; SolderJumper-2_P1.3mm_Open_RoundedPad1.0x1.5mm
JP3, JP4: BIAS; SolderJumper-2_P1.3mm_Open_RoundedPad1.0x1.5mm
JP5: NTC ON BOARD; SolderJumper-2_P1.3mm_Open_RoundedPad1.0x1.5mm
K1: SRD-05VDC-SL-C; RELAY-TH_SRD-XXVDC-XL-C
L1: 15uH; IND-SMD_L7.0-W6.6_FXL0630
L2: 2.2uH; IND-SMD_L4.0-W4.0
L3: 4.7uH; IND-SMD_L5.0-W5.0
Q1, Q2, Q4, Q7, Q8, Q9, Q10: 2N7002; SOT-23-3_L2.9-W1.3-P1.90-LS2.4-BR
Q5, Q11: AO3401A; SOT-23_L2.9-W1.3-P1.90-LS2.4-BR
Q6: FS8205A; SOT-23-6_L2.9-W1.6-P0.95-LS2.8-BR
Q12: AO3400A; SOT-23-3_L2.9-W1.3-P1.90-LS2.4-BR
R1, R2, R77: 5.1k; R_0603_1608Metric
R3, R8, R9, R10, R24, R26, R40, R41, R42, R43, R63, R70, R71, R81: 1k; R_0603_1608Metric
R4, R5, R11, R12, R15, R18, R20, R35, R44, R45, R46, R47, R50, R60, R65, R74, R75, R76: 10k; R_0603_1608Metric
R6, R7, R17, R25: 100; R_0603_1608Metric
R13, R14, R21, R27, R28, R29, R31, R51, R52, R58, R61, R62, R64, R79: 100k; R_0603_1608Metric
R16, R32: 15k; R_0603_1608Metric
R19, R30, R80: 200k; R_0603_1608Metric
R36, R37: 4.7k; R_0603_1608Metric
R55: 39k; R_0603_1608Metric
R56: 47k; R_0603_1608Metric
R57: 8.2k; R_0603_1608Metric
R59: 0.2R; R_1206_3216Metric
R66, R67, R69: 20k; R_0603_1608Metric
R68: 120; R_0603_1608Metric
R72, R73: 390; R_0603_1608Metric
R78: 68k; R_0603_1608Metric
RN1, RN2, RN3: 4x10k; RES-ARRAY-SMD_0603-8P-L3.2-W1.6-BL
RT1: 10k NTC B3950; R_0603_1608Metric
SW1: BOOT; SW-SMD_4P-L5.1-W5.1-P3.70-LS6.5-TL_H1.5
SW2: RESET; SW-SMD_4P-L5.1-W5.1-P3.70-LS6.5-TL_H1.5
SW3: TAMPER; SW-SMD_4P-L5.1-W5.1-P3.70-LS6.5-TL_H1.5
TP1: RS485_DI; TestPoint_Pad_D1.5mm
TP2: RS485_RO; TestPoint_Pad_D1.5mm
TP3: IO40; TestPoint_Pad_D1.5mm
TP4: GND; TestPoint_Pad_D1.5mm
U1: ESP32-S3-WROOM-1-N8R2; WIRELM-SMD_ESP32-S3-WROOM-1
U2: LMR16020; SOIC-8_L4.9-W3.9-P1.27-LS6.0-BL-EP
U3: TPS63001; Texas_DRC0010J
U4: SN74LVC2G17; SOT-23-6_L2.9-W1.6-P0.95-LS2.8-BL
U5: CN3058E; SOIC-8_L4.9-W3.9-P1.27-LS6.0-BL-EP3.3
U6: MT3608; SOT-23-6_L2.9-W1.6-P0.95-LS2.8-BL
U7: DW01A; SOT-23-6_L2.9-W1.6-P0.95-LS2.8-BL
U8: TCA9535; TSSOP-24_L7.8-W4.4-P0.65-LS6.4-BL
U9: SP3485; SOIC-8_L5.0-W4.0-P1.27-LS6.0-BL
U10: LMV321; SOT-23-5_L3.0-W1.7-P0.95-LS2.8-BR

Connections:
+3V3: C9.1, C10.1, C11.1, C12.1, C16.1, C36.1, C37.1, C39.1, D8.2, D23.1, J5.2, J6.1, J17.1, J18.2, J19.1, JP3.2, Q7.1, Q8.1, Q9.1, Q10.1, R3.1, R4.1, R5.1, R11.1, R12.1, R18.2, R35.1, R36.1, R37.1, R44.1, R45.1, R46.1, R47.1, R60.2, R61.2, R62.2, R66.2, R75.2, R76.2, U1.2, U3.1, U3.10, U4.5, U8.24, U9.8, U10.5
+5V: C20.1, D3.1, D4.1, D11.2, D12.2, D14.1, K1.1, Q5.1, R15.1, R27.1, R77.1, U5.4
+5V_BUCK: C4.1, C5.1, C35.1, D3.2, L1.2, R56.1, R58.2
+12V_RDR: D20.1, F1.2, J3.1, J21.1, R31.1
+VIN: C2.1, C31.1, C32.1, C33.1, C34.1, D1.1, D2.1, U2.2, U2.3
+VIN_F: D1.2, F2.2
+VIN_RAW: F2.1, J2.1, J14.4
BAT+: C21.1, J4.1, Q5.3, R25.1, R28.1, U5.5, U5.8
BAT-: C22.2, J4.2, Q6.1, U7.6
BAT_SENSE: C23.1, R28.2, R29.1, U1.39
BAT_TEMP: J4.3, JP5.1, R77.2, R78.1, R79.1, U5.1
BEEP_GATE: Q2.1, R7.2, R14.1
BOOST_FB: R19.2, R20.1, R30.1, U6.3
BOOST_OUT: C18.1, C19.1, D10.1, Q11.2, R19.1, R52.2
BOOST_SW: D10.2, L3.2, U6.1
CC1: J1.A5, R1.1
CC2: J1.B5, R2.1
CHRG: R24.1, R61.1, U5.7, U8.5
D0_IN: C14.1, D5.1, R9.2, R11.2, U4.1
D0_RAW: D15.1, J10.1, R9.1
D1_IN: C15.1, D6.1, R10.2, R12.2, U4.3
D1_RAW: D15.2, J10.2, R10.1
D7_A: D7.1, R3.2
D8_K: D8.1, R8.2
D12_K: D12.1, R24.2
D23_K: D23.2, R81.2
DISP_RST: J6.7, J19.3, RN1.1, U8.10
DONE_N: R62.1, U5.6, U8.6
EN: C13.1, R4.2, SW2.1, U1.3
ETH_CS: J17.6, U1.29
ETH_INT: J17.7, U1.30
ETH_MISO: J17.5, U1.28
ETH_RST: J17.8, R76.1, U8.9
EXP07: J19.4, RN1.2, U8.11
EXP10: J19.5, RN1.3, U8.13
EXP11: J19.6, RN1.4, U8.14
EXP12: J19.7, RN2.1, U8.15
EXP13: J19.8, RN2.2, U8.16
EXP14: J19.9, RN2.3, U8.17
EXP15: J19.10, RN2.4, U8.18
EXP16: J19.11, RN3.1, U8.19
EXP17: J19.12, U8.20
EXP_INT: R60.1, U1.32, U8.1
EXT_SENSE: R15.2, R16.1, U8.7
GND: C2.2, C4.2, C5.2, C6.2, C7.2, C8.2, C9.2, C10.2, C11.2, C12.2, C13.2, C14.2, C15.2, C16.2, C17.2, C18.2, C19.2, C20.2, C21.2, C23.2, C24.2, C27.2, C28.2, C29.2, C30.2, C31.2, C32.2, C33.2, C34.2, C35.2, C36.2, C37.2, C38.2, C39.2, C40.2, D2.2, D5.2, D6.2, D7.2, D13.2, D15.3, D16.3, D17.2, D18.2, D19.3, D20.2, D21.2, D22.2, J1.13, J1.14, J1.A1B12, J1.B1A12, J2.2, J4.4, J5.1, J6.2, J8.2, J12.1, J13.2, J14.2, J14.3, J17.2, J18.1, J19.2, JP1.2, JP4.2, Q1.2, Q2.2, Q4.2, Q6.3, Q12.2, R1.2, R2.2, R13.2, R14.2, R16.2, R20.2, R26.2, R27.2, R29.2, R32.2, R50.2, R55.2, R57.2, R59.2, R64.2, R65.2, R67.2, R70.2, R78.2, R80.2, RN1.5, RN1.6, RN1.7, RN1.8, RN2.5, RN2.6, RN2.7, RN2.8, RN3.8, RT1.2, SW1.4, SW2.4, SW3.4, TP4.1, U1.1, U1.40, U1.41, U2.7, U2.9, U3.3, U3.7, U3.9, U3.11, U4.2, U5.3, U5.9, U6.2, U8.2, U8.3, U8.12, U8.21, U9.5, U10.2
I2C_SCL: J5.3, J18.4, R37.2, U1.35, U8.22
I2C_SDA: J5.4, J18.3, R36.2, U1.34, U8.23
IN1: C27.1, Q7.2, R44.2, U1.8
IN1_D: Q7.3, R40.2
IN1_RAW: D17.1, J9.1, R40.1
IN2: C28.1, Q8.2, R45.2, U1.9
IN2_D: Q8.3, R41.2
IN2_RAW: D18.1, J9.2, R41.1
IN3: C29.1, Q9.2, R46.2, U1.10
IN3_D: Q9.3, R42.2
IN3_RAW: D21.1, J12.2, R42.1
IN4: C30.1, Q10.2, R47.2, U1.11
IN4_D: Q10.3, R43.2
IN4_RAW: D22.1, J13.1, R43.1
IO0: R5.2, SW1.1, U1.27
IO6: R6.1, U1.6
IO21: R8.1, U1.23
IO40: R7.1, TP3.1, U1.33
IO47: R81.1, U1.24
IO48: R17.1, U1.25
ISET: R50.1, U5.2
ISNS_FB: R69.2, R70.1, U10.3
ISNS_IN: R74.2, U10.1
ISNS_OUT: R69.1, R71.1, U10.4
JP1_A: JP1.1, R30.2
JP2_A: JP2.1, R68.2
JP3_A: JP3.1, R72.2
JP4_A: JP4.1, R73.2
LED_GATE: Q1.1, R6.2, R13.1
OC: Q6.4, U7.3
OD: Q6.6, U7.1
PGOOD5: R58.1, U2.6, U8.8
Q4_D: Q4.3, R51.2
Q4_G: Q4.1, R17.2, R18.1
Q6_D: Q6.2, Q6.5
Q11_G: Q11.1, R51.1, R52.1
Q12_G: Q12.1, R63.2, R64.1
RDR_BEEP: D16.2, J11.2, Q2.3
RDR_GND: J3.2, J21.2, R59.1, R74.1
RDR_ISENSE: C38.1, R71.2, U1.17
RDR_LED: D16.1, J11.1, Q1.3
RDR_MON: C24.1, R31.2, R32.1, U1.38
RDR_SW: F1.1, Q11.3
RELAY_COIL: D14.2, K1.4, Q12.3
RELAY_COM: J16.2, K1.5
RELAY_DRV: R63.1, U8.4
RELAY_NC: J15.1, K1.3
RELAY_NO: J15.2, K1.2
RS485_A: D19.1, J20.1, R66.1, R68.1, R72.1, U9.6
RS485_B: D19.2, J20.2, JP2.2, R67.1, R73.1, U9.7
RS485_DE: R65.1, U1.31, U9.2, U9.3
RS485_DI: TP1.1, U1.37, U9.4
RS485_RO: R75.1, TP2.1, U1.36, U9.1
RT1_A: JP5.2, RT1.1
SPI_BL_BUSY: J6.8, U1.22
SPI_CS: J6.5, U1.18
SPI_DC: J6.6, U1.21
SPI_MOSI: J6.4, J17.4, U1.19
SPI_SCK: J6.3, J17.3, U1.20
TAMPER: J8.1, R35.2, SW3.1, U1.12
TEMP_ADC: C40.1, R79.2, R80.1, U1.15
U2_BST: C3.1, U2.1
U2_FB: R56.2, R57.1, U2.5
U2_RT: R55.1, U2.4
U2_SW: C3.2, D13.1, L1.1, U2.8
U3_L1: L2.1, U3.4
U3_L2: L2.2, U3.2
U6_EN: R21.2, U6.4
U7_VCC: C22.1, R25.2, U7.5
USB_DN: J1.A7, J1.B7, U1.13
USB_DP: J1.A6, J1.B6, U1.14
VBUS: C6.1, D4.2, J1.A4B9, J1.B4A9
VM: R26.1, U7.2
VSYS: C7.1, C8.1, C17.1, D11.1, L3.1, Q5.2, R21.1, U3.5, U3.6, U3.8, U6.5
WG_D0: U1.4, U4.6
WG_D1: U1.5, U4.4
