EdgeCoil/wiegand-bridge/hardware/lite/wiegand-bridge-lite.kicad_pcb

## KiCad design hardware/lite/wiegand-bridge-lite.kicad_pcb (2026-10-21)

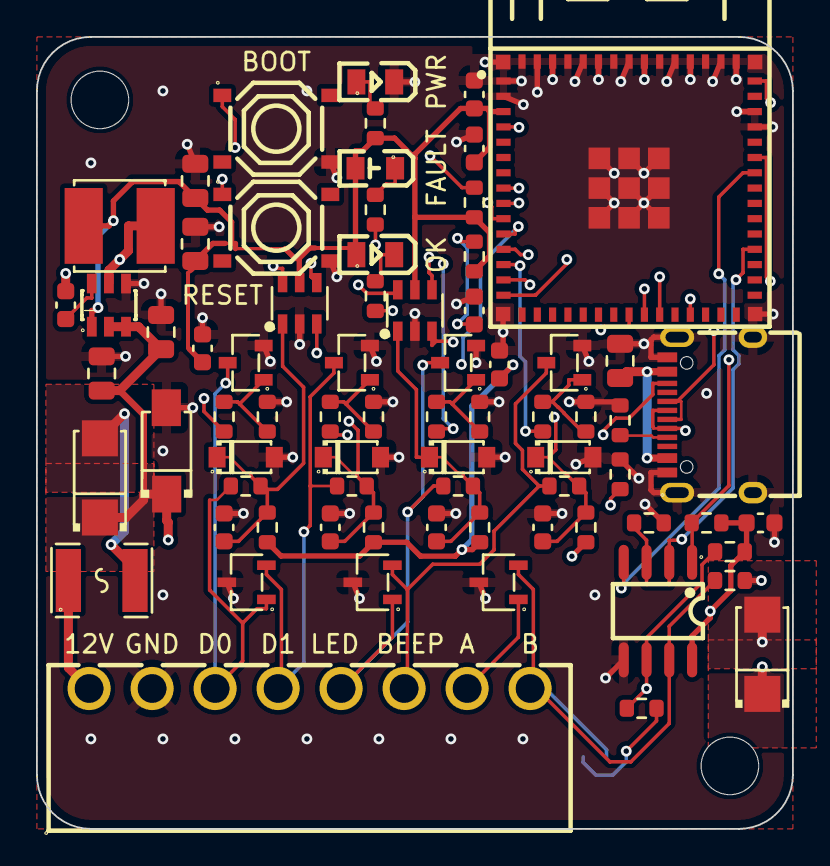
[picture p38: board wiegand-bridge-lite.kicad_pcb from above]

Board: 4 copper layers, 42.0 x 44.0 mm, 75 parts (1 on the bottom side), 45 nets.

Parts:
C1, C2, C6: 10u; C_0805_2012Metric
C3, C12, C16, C37, C41: 100n; C_0603_1608Metric
C4, C5: 22u; C_0805_2012Metric
C11: 22u; C_0603_1608Metric
C13: 1u; C_0603_1608Metric
C14, C15, C42, C43: 100p; C_0603_1608Metric
D1, D3: SS34; SMA_L4.3-W2.6-LS5.2-RD
D2: SMAJ18A; SMA_L4.3-W2.6-LS5.0-RD
D5, D6, D24, D25: MMSZ5231B; SOD-123_L2.8-W1.6-LS3.7-RD
D7, D23: green; LED0805-R-RD
D8: red; LED0805-RD
D15, D16, D19: SM712; SOT-23-3_L3.0-W1.7-P0.95-LS2.9-BR
F1: 0.5A 24V; F1812
H1, H2: M3; MountingHole_3.2mm_M3
J1: USB-C; USB-C-SMD_TYPE-C-16PIN-2MD-073
J3: 12V GND D0 D1 LED BEEP A B; CONN-TH_8P-P3.50_KF2EDGR-3.5-8P
JP2: TERM; SolderJumper-2_P1.3mm_Open_RoundedPad1.0x1.5mm
L1: 4.7uH; IND-SMD_L5.0-W5.0
Q1, Q2, Q3, Q4: 2N7002; SOT-23-3_L2.9-W1.3-P1.90-LS2.4-BR
R1, R2: 5.1k; R_0603_1608Metric
R3, R8, R9, R10, R20, R21, R81: 1k; R_0603_1608Metric
R4, R5, R11, R12, R22, R23, R65, R75: 10k; R_0603_1608Metric
R6, R7, R24, R26: 100; R_0603_1608Metric
R13, R14, R25, R27: 100k; R_0603_1608Metric
R66, R67: 20k; R_0603_1608Metric
R68: 120; R_0603_1608Metric
SW1: BOOT; SW-SMD_4P-L5.1-W5.1-P3.70-LS6.5-TL_H1.5
SW2: RESET; SW-SMD_4P-L5.1-W5.1-P3.70-LS6.5-TL_H1.5
U1: ESP32-S3-MINI-1-N4R2; BULETM-SMD_ESP32-S3-MINI-1-N8
U2: AP63203; TSOT-26_L2.9-W1.6-P0.95-LS2.8-BL
U4, U11: SN74LVC2G17; SOT-23-6_L2.9-W1.6-P0.95-LS2.8-BL
U9: SP3485; SOIC-8_L5.0-W4.0-P1.27-LS6.0-BL

Connections:
+3V3: C4.1, C5.1, C11.1, C12.1, C16.1, C37.1, C41.1, D8.2, D23.1, L1.2, R3.1, R4.1, R5.1, R11.1, R12.1, R22.1, R23.1, R66.2, R75.2, U1.3, U2.1, U4.5, U9.8, U11.5
+VIN: C1.1, C2.1, D1.1, D2.1, D3.1, U2.2, U2.3
+VIN_F: D1.2, F1.2
+VIN_RAW: F1.1, J3.1
BEEP_IN: C43.1, D25.1, R21.2, R23.2, U11.3
BEEP_RX: U1.15, U11.4
BEEP_TX: R7.1, U1.13
CC1: J1.A5, R1.1
CC2: J1.B5, R2.1
D0_IN: C14.1, D5.1, R9.2, R11.2, U4.1
D0_RAW: D15.1, J3.3, Q3.3, R9.1
D0_TX: R24.1, U1.10
D1_IN: C15.1, D6.1, R10.2, R12.2, U4.3
D1_RAW: D15.2, J3.4, Q4.3, R10.1
D1_TX: R26.1, U1.11
D7_A: D7.1, R3.2
D8_K: D8.1, R8.2
D23_K: D23.2, R81.2
EN: C13.1, R4.2, SW2.1, U1.45
GND: C1.2, C2.2, C4.2, C5.2, C6.2, C11.2, C12.2, C13.2, C14.2, C15.2, C16.2, C37.2, C41.2, C42.2, C43.2, D2.2, D5.2, D6.2, D7.2, D15.3, D16.3, D19.3, D24.2, D25.2, J1.13, J1.14, J1.A1B12, J1.B1A12, J3.2, Q1.2, Q2.2, Q3.2, Q4.2, R1.2, R2.2, R13.2, R14.2, R25.2, R27.2, R65.2, R67.2, SW1.4, SW2.4, U1.1, U1.2, U1.42, U1.43, U1.46, U1.47, U1.48, U1.49, U1.50, U1.51, U1.52, U1.53, U1.54, U1.55, U1.56, U1.57, U1.58, U1.59, U1.60, U1.GND, U2.4, U4.2, U9.5, U11.2
IO0: R5.2, SW1.1, U1.4
IO21: R8.1, U1.25
IO47: R81.1, U1.27
JP2_A: JP2.1, R68.2
LED_IN: C42.1, D24.1, R20.2, R22.2, U11.1
LED_RX: U1.14, U11.6
LED_TX: R6.1, U1.12
Q1_G: Q1.1, R6.2, R13.1
Q2_G: Q2.1, R7.2, R14.1
Q3_G: Q3.1, R24.2, R25.1
Q4_G: Q4.1, R26.2, R27.1
RDR_BEEP: D16.2, J3.6, Q2.3, R21.1
RDR_LED: D16.1, J3.5, Q1.3, R20.1
RS485_A: D19.1, J3.7, R66.1, R68.1, U9.6
RS485_B: D19.2, J3.8, JP2.2, R67.1, U9.7
RS485_DE: R65.1, U1.34, U9.2, U9.3
RS485_DI: U1.39, U9.4
RS485_RO: R75.1, U1.40, U9.1
U2_BST: C3.1, U2.6
U2_SW: C3.2, L1.1, U2.5
USB_DN: J1.A7, J1.B7, U1.23
USB_DP: J1.A6, J1.B6, U1.24
VBUS: C6.1, D3.2, J1.A4B9, J1.B4A9
WG_D0: U1.8, U4.6
WG_D1: U1.9, U4.4
