EdgeCoil/wiegand-bridge/firmware/wiegand-bridge.yaml

# SPDX-FileCopyrightText: 2026 edgecoil
# SPDX-License-Identifier: MIT
# edgecoil wiegand-bridge -- ESPHome config for the revision 10 board (hardware/).
#
# Written for the rev 11 board, and tested on rev 10, where IO47 (rev 11's green OK LED) goes only to
# the unfitted J6, so driving it is harmless. Work through docs/design.md *Bench tests* first.
# The OLED is an optional package (wiegand-bridge-oled.yaml): include it once a screen is fitted.
#
# THIS DEVICE ONLY REPORTS. There is no relay output defined: credentials go to Home Assistant as
# events, HA decides, and any unlock happens elsewhere, through whatever actuator HA already controls.
# A reader-side board usually sits where anyone can reach it -- read docs/design.md *Security*:
# an isolated IoT network, HA's "allow device actions" OFF, a device_id check, a tamper alert.
#
# Secrets (secrets.yaml): wifi_ssid, wifi_password, wiegand_bridge_api_key, wiegand_bridge_ota_password.

substitutions:
  name: wiegand-bridge
  friendly_name: Wiegand bridge

esphome:
  name: ${name}
  friendly_name: ${friendly_name}

esp32:
  board: esp32-s3-devkitc-1
  variant: esp32s3
  flash_size: 8MB
  framework:
    type: esp-idf

psram:
  mode: quad                     # N8R2. NOT octal -- the wrong mode fails at runtime
  speed: 80MHz

wifi:
  ssid: !secret wifi_ssid
  password: !secret wifi_password

api:
  encryption:
    key: !secret wiegand_bridge_api_key
  actions:
    - action: feedback_granted
      then:
        - logger.log:            # INFO, so a caller can confirm the action ran (no credential in it)
            level: INFO
            format: "feedback: granted"
        - lambda: 'id(screen_text) = "Granted";'
        - script.execute: screen_wake
        # Three green pulses, then green held 3 s. On most readers the LED line is a level input:
        # pulled low = green. Not every reader wires BEEP; it is kept for those that do.
        - output.turn_on: reader_beep
        - repeat:
            count: 3
            then:
              - output.turn_on: reader_led
              - delay: 300ms
              - output.turn_off: reader_led
              - delay: 200ms
              - output.turn_off: reader_beep
        - output.turn_on: reader_led
        - delay: 3s
        - output.turn_off: reader_led
    - action: feedback_denied
      then:
        - logger.log:
            level: INFO
            format: "feedback: denied"
        - lambda: 'id(screen_text) = "Denied";'
        - script.execute: screen_wake
        - repeat:
            count: 3
            then:
              - output.turn_on: reader_beep
              - delay: 100ms
              - output.turn_off: reader_beep
              - delay: 100ms

ota:
  - platform: esphome
    password: !secret wiegand_bridge_ota_password

logger:
  level: INFO
  hardware_uart: USB_SERIAL_JTAG   # rev 10: UART0 (IO43/44) is the RS-485 port
  # NEVER raise to DEBUG in service: debug logs the Wiegand frames, i.e. the codes.

i2c:
  - id: bus_a
    sda: GPIO41
    scl: GPIO42

# rev 10: TCA9535 at 0x20 (register-compatible with PCA9555 -> the pca9554 component, 16 pins).
# P00 relay drive (spare boards only -- deliberately NOT defined on the door unit), P01 CHRG,
# P02 DONE, P03 external power, P04 5 V power-good, P05 W5500 reset, P06-P17 to the 2x6 header.
pca9554:
  - id: io_exp
    i2c_id: bus_a
    address: 0x20
    pin_count: 16

# rev 10: RS-485 / OSDP port on UART0 (SP3485, DE on IO38). No OSDP component exists in ESPHome
# yet; the UART is declared so the pins are claimed and the port can be bench-tested.
uart:
  - id: rs485
    tx_pin: GPIO43
    rx_pin: GPIO44
    baud_rate: 9600

wiegand:
  - id: reader
    d0: GPIO4                    # via U4 74LVC2G17
    d1: GPIO5
    on_key:                      # keys reach pin_input through its source_id, AFTER this trigger runs
      then:
        - script.execute: screen_wake
        # On many keypads the bell key IS '#' (11). '#' with no digits typed rings the doorbell;
        # '#' after 1-3 digits clears the entry, because key_collector keeps a too-short entry
        # (so "12#3456#" would otherwise submit 123456). 4+ digits: key_collector submits it.
        - lambda: |-
            const uint32_t now = millis();
            if (now - id(last_key_ms) > 10000) id(digits_typed) = 0;   // mirrors pin_input's timeout
            id(last_key_ms) = now;
            if (x <= 9) {
              id(digits_typed)++;
            } else if (x == 10) {                                      // '*'
              id(digits_typed) = 0;
            } else if (x == 11) {                                      // '#'
              if (id(digits_typed) >= 4) {
                id(last_submit_ms) = now;
              } else if (id(digits_typed) > 0) {
                id(pin_input).clear();
              } else if (now - id(last_submit_ms) > 2000) {            // a habitual second '#' is not a ring
                id(doorbell).trigger("ring");
              }
              id(digits_typed) = 0;
            }
    on_tag:
      then:
        - script.execute: screen_wake
        - homeassistant.event:
            event: esphome.wiegand_bridge
            data:
              type: fob
              value: !lambda "return x;"

key_collector:
  - id: pin_input
    source_id: reader
    min_length: 4
    max_length: 10
    end_keys: "#"
    end_key_required: true
    clear_keys: "*"
    timeout: 10s
    # Masked live entry: one '*' per digit typed, empty on clear/timeout/submit. NEVER the digits --
    # this is an entity, so once adopted it lands in HA's history.
    on_progress:
      then:
        - text_sensor.template.publish:
            id: entry_progress
            state: !lambda "return std::string(x.size(), '*');"
    on_result:
      then:
        - homeassistant.event:
            event: esphome.wiegand_bridge
            data:
              type: code
              value: !lambda "return x.c_str();"

output:
  # Spare expander pin P17 has no pull-down on the board (it could not be routed): declared as an
  # output (default off = low) so it is never a floating input. P06-P16 are tied low by RN1-RN3.
  - platform: gpio
    id: exp_p17_tie_low
    pin: {pca9554: io_exp, number: 15}
  - platform: gpio
    id: reader_led
    pin: GPIO6                   # Q1 -> J11 LED (confirm polarity on the bench)
  - platform: gpio
    id: reader_beep
    pin: GPIO40                  # Q2 -> J11 BEEP (rev 10: moved from IO7, which could not be routed out)
  - platform: gpio
    id: reader_shed
    pin:
      number: GPIO48
      inverted: true             # R18 holds IO48 high = reader on; turn_on drives it low = shed
  - platform: gpio
    id: status_ok_led
    pin:
      number: GPIO47
      inverted: true             # rev 11: D23 green OK sinks into the pin (rev 10: J6 RST, not fitted)

# Status pair (rev 11): red FAULT = ESPHome's status LED (slow blink warning, fast blink error);
# green OK = steady while a client (Home Assistant) is connected to the API.
interval:
  - interval: 1s
    then:
      - if:
          condition:
            api.connected:
          then:
            - output.turn_on: status_ok_led
          else:
            - output.turn_off: status_ok_led



light:
  - platform: status_led
    name: "${friendly_name} status"
    pin:
      number: GPIO21
      inverted: true             # D8 sinks into the pin (red FAULT since rev 11; yellow on rev 10)

binary_sensor:
  - platform: status
    name: "${friendly_name} online"
  - platform: gpio
    name: "${friendly_name} tamper"
    device_class: tamper
    pin:
      number: GPIO8              # lid on = SW3 closed = low
    filters:
      - delayed_on: 200ms
  - platform: gpio
    id: ext_power
    name: "${friendly_name} external power"
    device_class: power
    pin: {pca9554: io_exp, number: 3}       # +5V divider, ~2.8 V when present (rev 10: via the expander)
    on_press:
      - output.turn_off: reader_shed
  - platform: gpio
    name: "${friendly_name} battery charging"
    device_class: battery_charging
    pin: {pca9554: io_exp, number: 1, inverted: true}   # CN3058E CHRG, open drain, low = charging
  - platform: gpio
    name: "${friendly_name} battery charged"
    pin: {pca9554: io_exp, number: 2, inverted: true}   # CN3058E DONE, low = full
  - platform: gpio
    name: "${friendly_name} 5 V supply OK"
    device_class: power
    entity_category: diagnostic
    pin: {pca9554: io_exp, number: 4}       # LMR16020 PGOOD
  - platform: gpio
    name: "${friendly_name} input 1"
    pin: {number: GPIO15, inverted: true}
    filters: [delayed_on_off: 30ms]
  - platform: gpio
    name: "${friendly_name} input 2"
    pin: {number: GPIO16, inverted: true}
    filters: [delayed_on_off: 30ms]
  - platform: gpio
    name: "${friendly_name} input 3"
    pin: {number: GPIO17, inverted: true}
    filters: [delayed_on_off: 30ms]
  - platform: gpio
    name: "${friendly_name} input 4"
    pin: {number: GPIO18, inverted: true}
    filters: [delayed_on_off: 30ms]

sensor:
  - platform: wifi_signal
    name: "${friendly_name} RSSI"
    update_interval: 300s
  - platform: adc
    pin: GPIO2
    name: "${friendly_name} reader supply"
    attenuation: 12db
    filters:
      - multiply: 7.667          # R31 100k / R32 15k
    update_interval: 60s
  - platform: adc
    pin: GPIO9
    name: "${friendly_name} reader current"
    unit_of_measurement: mA
    attenuation: 12db
    filters:
      - multiply: 238.1          # 0.2 ohm shunt x 21 gain: 4.2 mV per mA (sim/isense.cir)
    update_interval: 30s
  - platform: adc
    id: battery_v
    pin: GPIO1
    name: "${friendly_name} battery"
    attenuation: 12db
    filters:
      - multiply: 2.0
    update_interval: 60s
    on_value_range:
      - below: 3.0
        then:
          - if:
              condition:
                binary_sensor.is_off: ext_power
              then:
                - output.turn_on: reader_shed

  # Battery thermistor (rev 10, 2026-10-11): U5's TEMP divider (R77 5.1k from +5V, R78 68k, a 10k
  # B3950 NTC on the cell at J4 pins 3-4, or RT1 via JP5) read through R79/R80 (2/3) on IO3.
  # The divider is fed from +5V, so it only reads while external power is present.
  - platform: adc
    id: bat_temp_adc
    pin: {number: GPIO3, ignore_strapping_warning: true}   # IO3 strap only matters with JTAG eFuses burnt
    attenuation: 12db
    internal: true
    update_interval: 60s
  - platform: template
    id: bat_ntc_ohms
    internal: true
    unit_of_measurement: "Ω"
    update_interval: 60s
    lambda: |-
      if (!id(ext_power).state) return NAN;          // divider unpowered on battery
      const float vt = id(bat_temp_adc).state * 1.5f; // undo R79/R80
      const float v5 = 4.7f;                          // +5V after the OR diode, nominal
      if (vt >= v5 * 0.88f) return NAN;               // no thermistor (open reads ~91 %): U5 is not charging
      const float rx = 5100.0f * vt / (v5 - vt);      // R77
      const float g = 1.0f / rx - 1.0f / 68000.0f - 1.0f / 300000.0f;   // remove R78 and R79+R80
      return g > 0 ? 1.0f / g : NAN;
  - platform: ntc
    sensor: bat_ntc_ohms
    name: "${friendly_name} battery temperature"
    calibration:
      b_constant: 3950
      reference_temperature: 25°C
      reference_resistance: 10kOhm

globals:
  - id: screen_text
    type: std::string
    initial_value: '"Present card or enter code"'
  - id: screen_awake              # read by wiegand-bridge-oled.yaml; harmless with no screen
    type: bool
    initial_value: 'false'
  - id: digits_typed              # doorbell / short-entry logic in the wiegand on_key
    type: int
    initial_value: '0'
  - id: last_key_ms
    type: uint32_t
    initial_value: '0'
  - id: last_submit_ms
    type: uint32_t
    initial_value: '0'

text_sensor:
  - platform: template
    id: entry_progress
    name: "${friendly_name} entry"
    icon: mdi:dialpad

event:
  - platform: template
    id: doorbell
    name: "${friendly_name} doorbell"
    device_class: doorbell
    event_types: [ring]

# The OLED lives in its own package so a board without one has no FAILED component (which
# blinks the status LED as an error). Uncomment once the SH1106 is on J5.
# packages:
#   oled: !include wiegand-bridge-oled.yaml

script:
  - id: screen_wake
    mode: restart
    then:
      - lambda: id(screen_awake) = true;
      - delay: 60s
      - lambda: |-
          id(screen_text) = "Present card or enter code";
          id(screen_awake) = false;
