EdgeCoil/wiegand-bridge/(commit log)

2026-10-15 wiegand-bridge revision 10: board, fab outputs, ESPHome config, design notes
    [wiegand-bridge-B_Cu.gbl, wiegand-bridge-B_Mask.gbs, wiegand-bridge-B_Paste.gbp, wiegand-bridge-B_Silkscreen.gbo, wiegand-bridge-Edge_Cuts.gm1, wiegand-bridge-F_Cu.gtl, wiegand-bridge-F_Mask.gts, wiegand-bridge-F_Paste.gtp]
2026-10-15 Licence: CERN-OHL-S-2.0 board, MIT firmware and tools, CC BY 4.0 docs
    The scripts that define the board (netlist, placement, build, routes) are part of the hardware
    source and carry CERN-OHL-S. The edgecoil name and mark are not licensed.
2026-10-15 rev 10b: back silkscreen links wiegand.edgecoil.dev
    Silkscreen-only change (the CERN-OHL-S source location). Copper, mask, paste, drill, outline, BOM
    and CPL are unchanged; DRC results are identical to rev 10.
    [wiegand-bridge-B_Cu.gbl, wiegand-bridge-B_Mask.gbs, wiegand-bridge-B_Paste.gbp, wiegand-bridge-B_Silkscreen.gbo, wiegand-bridge-Edge_Cuts.gm1, wiegand-bridge-F_Cu.gtl, wiegand-bridge-F_Mask.gts, wiegand-bridge-F_Paste.gtp]
2026-10-20 LITE rev 1 (under development): 42 x 44 mm board, firmware, design notes, size comparison
    ESP32-S3-MINI-1, 8-16 V in (AP63203 to 3.3 V, USB-C bench power), one 8-way 3.5 mm pluggable
    terminal, D0/D1/LED/BEEP bidirectional (reader emulation), SP3485 kept. Routed, DRC clean, fab
    outputs generated; firmware compiles. No board made yet.
    [wiegand-bridge-lite-B_Cu.gbl, wiegand-bridge-lite-B_Mask.gbs, wiegand-bridge-lite-B_Paste.gbp, wiegand-bridge-lite-B_Silkscreen.gbo, wiegand-bridge-lite-Edge_Cuts.gm1, wiegand-bridge-lite-F_Cu.gtl, wiegand-bridge-lite-F_Mask.gts, wiegand-bridge-lite-F_Paste.gtp]
2026-10-20 Renders: USB-C 3D model added, DC jack model turned to face the board edge; LITE renders and size comparison regenerated
    Render-only: the footprints and pads were right. The DC-005 model from EasyEDA sits backwards
    and off its outline; build_pcb.py now corrects it. The USB-C model was never fetched.
    [wiegand-bridge.kicad_pcb]
2026-10-20 Renders: passives shown (KiCad stock 0603/0805 models); README notes where fab.py looks for them
2026-10-20 Renders: DC jack model mirrored and placed on its outline (render-only); all parts shown
    [wiegand-bridge.kicad_pcb]
2026-10-20 LITE: TVS swapped to the Preferred SMAJ18A (no loading fee, 54k stock); re-routed, fab outputs and renders regenerated; cost note
    [wiegand-bridge-lite-B_Cu.gbl, wiegand-bridge-lite-B_Mask.gbs, wiegand-bridge-lite-B_Paste.gbp, wiegand-bridge-lite-B_Silkscreen.gbo, wiegand-bridge-lite-Edge_Cuts.gm1, wiegand-bridge-lite-F_Cu.gtl, wiegand-bridge-lite-F_Mask.gts, wiegand-bridge-lite-F_Paste.gtp]
2026-10-20 LITE: add the KiCad project file (netclasses); README notes why DRC needs it
2026-10-21 LITE: review pass -- antenna keep-out rule area, emulation actions moved to a bench-only package (no HA setting gates HA->device actions), IO38 claimed, verify.py 12 sections, gndcheck sees thermal s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
    [wiegand-bridge-lite-B_Cu.gbl, wiegand-bridge-lite-B_Mask.gbs, wiegand-bridge-lite-B_Paste.gbp, wiegand-bridge-lite-B_Silkscreen.gbo, wiegand-bridge-lite-Edge_Cuts.gm1, wiegand-bridge-lite-F_Cu.gtl, wiegand-bridge-lite-F_Mask.gts, wiegand-bridge-lite-F_Paste.gtp]
2026-10-25 README rewritten for readability; rev 10 is built, tested and working
    Status, how it works with a minimal HA automation, getting started and ordering come first;
    features grouped; build details after. The firmware header no longer says untested, and notes the
    tested installation's additions that aren't in this file yet.
    [wiegand-bridge.yaml]
2026-10-25 Firmware: the tested build's features ported; OLED as an optional package; LITE render in the README
    From the configuration running on the tested rev 10 board:
    - '#' with nothing typed fires a doorbell event entity; an entry too short to submit is cleared
    instead of being joined to the next one (12#3456# no longer submits 123456)
    - a masked 'entry' text sensor (one * per digit, never the digits)
    - granted: three LED pulses then held 3 s; both feedback actions log at INFO
    - the OLED moved to wiegand-bridge-oled.yaml, so a board without a screen shows no fault
    Left out: rev 11's OK LED and a bench-only BLE demo. Both variants pass esphome config, and the
    OLED variant compiles on ESPHome 2026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
    [wiegand-bridge.yaml]
2026-10-25 Revision 11: red/green status pair and silkscreen legibility (routed and checked, not yet ordered)
    Rev 10 is built and tested and stays available as tag rev-10b.
    - D8 becomes red FAULT (IO21, ESPHome's status LED); new D23 green OK on IO47 via R81, lit while
    Home Assistant is connected. DISP_RST moves from IO47 to expander P06 (shared with J19 pin 3).
    - Every silkscreen label held clear of pads, outlines, fitted parts and other text; audit.py --silk
    checks it (rev 10 had 41 problems in 70 labels). stitch.py keeps vias out of through-hole pads.
    - Fab outputs and renders regenerated; the schematic PDF title now says revision 11.
    - Firmware drives the OK LED (harmless on rev 10, where IO47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
    [wiegand-bridge-B_Cu.gbl, wiegand-bridge-B_Mask.gbs, wiegand-bridge-B_Paste.gbp, wiegand-bridge-B_Silkscreen.gbo, wiegand-bridge-Edge_Cuts.gm1, wiegand-bridge-F_Cu.gtl, wiegand-bridge-F_Mask.gts, wiegand-bridge-F_Paste.gtp]
2026-11-01 Design notes: rev 12 plan (standalone access controller, supervised-zone alarm via an expansion board)
